bendelathouwer/Advanced-PCB/av en presentatie/Job1-13.jpg

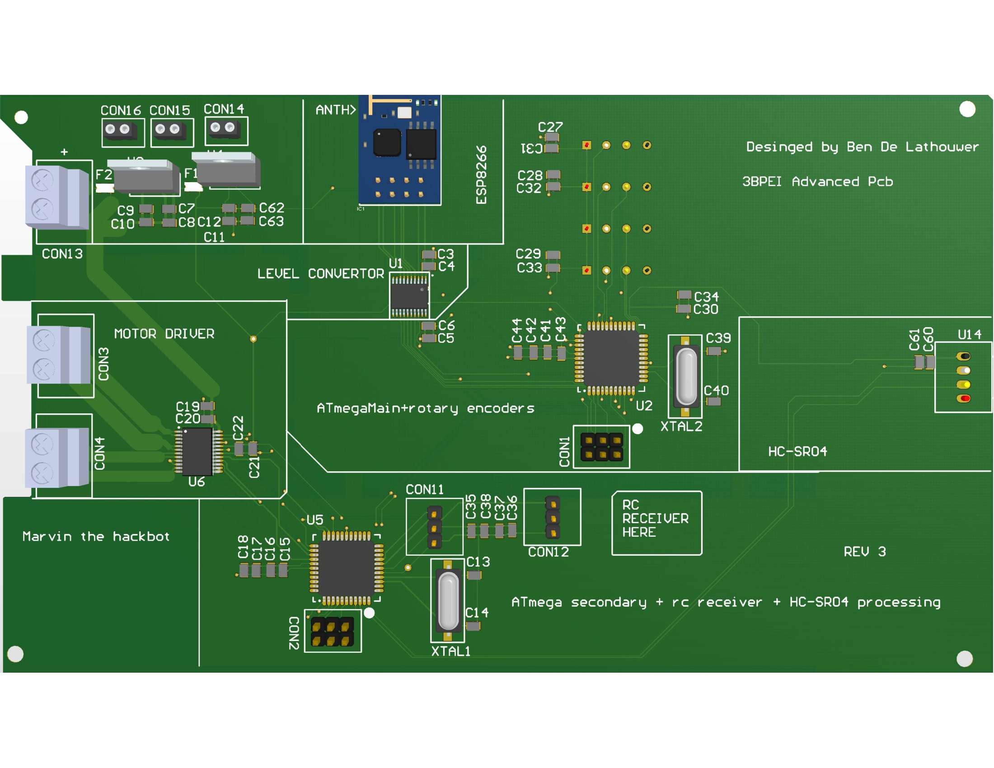
av en presentatie/Job1-13.jpg
