bendelathouwer/Advanced-PCB/av en presentatie/soort encoder.PNG

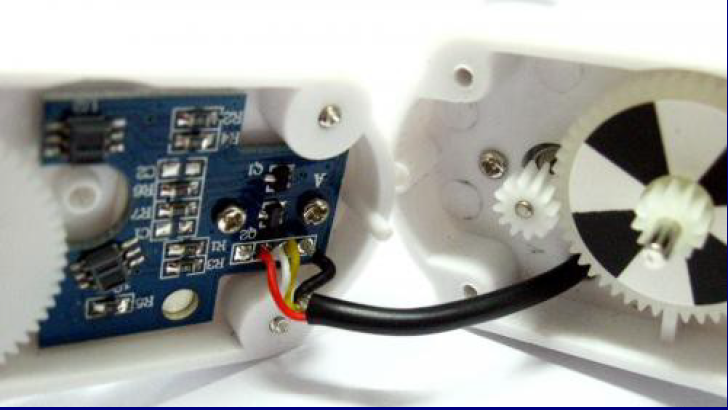
av en presentatie/soort encoder.PNG
