bendelathouwer/Advanced-PCB/Poster_BDL.pptx

- Marvin, the Paranoid Android

- Docent: J. Van Bauwel
- Vak: Project 2
- Student: Ben De Lathouwer
- Academiejaar: 2015-2016

- Doel

- Een rijdende RC robot die stopt als hij een obstakel te dicht naderT.

- componenten

- ATmega162 controller
- ultrasoon sensor
- motordriver
- Robot chassis met 4 Wielen (met elk een electro motor+ encoder)
- ESP8266p

Marvin

De programmeeromgeving

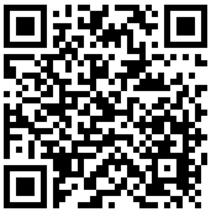
[picture p3: figure]

Onderkant Prototype van de print

- Patrick Pelgrims
- E-mail: Patrick.pelgrims@thomasmore.be
- Thomas More | Campus De Nayer
- Jan Pieter De Nayerlaan 5
- 2860 St.-Katelijne-Waver
- Tel: +32 (0)15 316944 | Fax: +32 (0)15 317453

Gebruikte onderdelen

## Slide 2

- Patrick Pelgrims
- E-mail: Patrick.pelgrims@thomasmore.be
- Thomas More | Campus De Nayer
- Jan Pieter De Nayerlaan 5
- 2860 St.-Katelijne-Waver
- Tel: +32 (0)15 316944 | Fax: +32 (0)15 317453

- Docent:Patric Pelgrims
- Jurre De Weerd
- Vak: Advanced Pcb
- Student: Ben De Lathouwer
- Academiejaar: 2016-2017

- Marvin, The Paranoid Android

- PCB verbeteringen

Layers

3D-render

- Meer interesse?

- Indien deze poster uw interesse geprikkeld heEft, kan u altijd mijn werk terugvinden op github:
- https://github.com/bendelathouwer/Psoc_robot
- voor vragen kan u me contacteren op: bendelathouwer@gmail.com

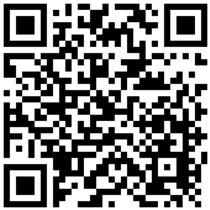
[picture p4: figure]
