bendelathouwer/Advanced-PCB/bestellijst farnell.docx

http://be.farnell.com/bourns/nsmf020-2/multifuse-smd-0-2a/dp/1206716

http://be.farnell.com/avx/08051a120jat2a/cap-mlcc-c0g-np0-12pf-100v-0805/dp/1740650

http://be.farnell.com/atmel/atmega162-16au/mcu-8bit-atmega-16mhz-tqfp-44/dp/9171150

http://be.farnell.com/littelfuse/0440002-wr/fuse-smd-2a-1206-fast-acting/dp/1835291
