bendelathouwer/Advanced-PCB/av en presentatie/Advanced pcb labo NL.pptx

## Advanced pcb labo

Henry the Hackbot
door Ben De Lathouwer

Henry the Hackbot

## Agenda

- Inleiding
- Doel van dit project
- Electronische schema’s en vergelijking
- Overzicht verbeteringen V4
- Wat heb ik geleerd?
- Vragen en Antwoorden

## Inleiding

- Leren werken met SMD PCB:
  - Debuggen
  - Solderen ‘in het klein’
- Gebruik van Altium

## Doel van het project

- Verbetering van het vak: project 2
  - Van Marvin naar Henry
- Mecatronica onder de knie krijgen
- Henry:
  - Gaat botsingen vermijden

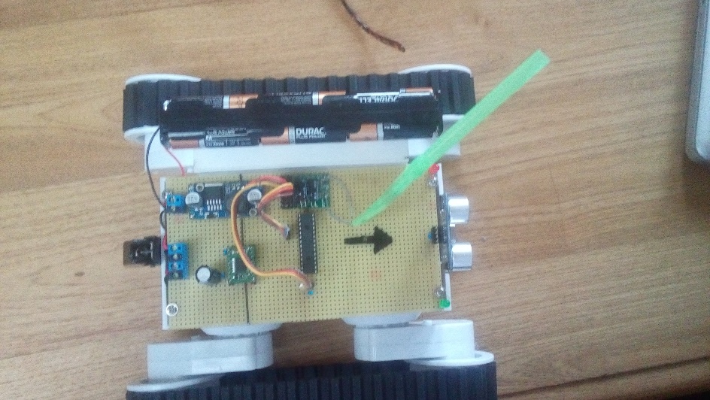
[picture p5: figure]

## Hoofd microcontroller

- Onderdelen:
  - Data genereren voor ESP8266
  - Level convertor sturen
  - Data van de secundaire controller ontvangen
  - Encoders uitlezen

## Hoofd microcontroller V2

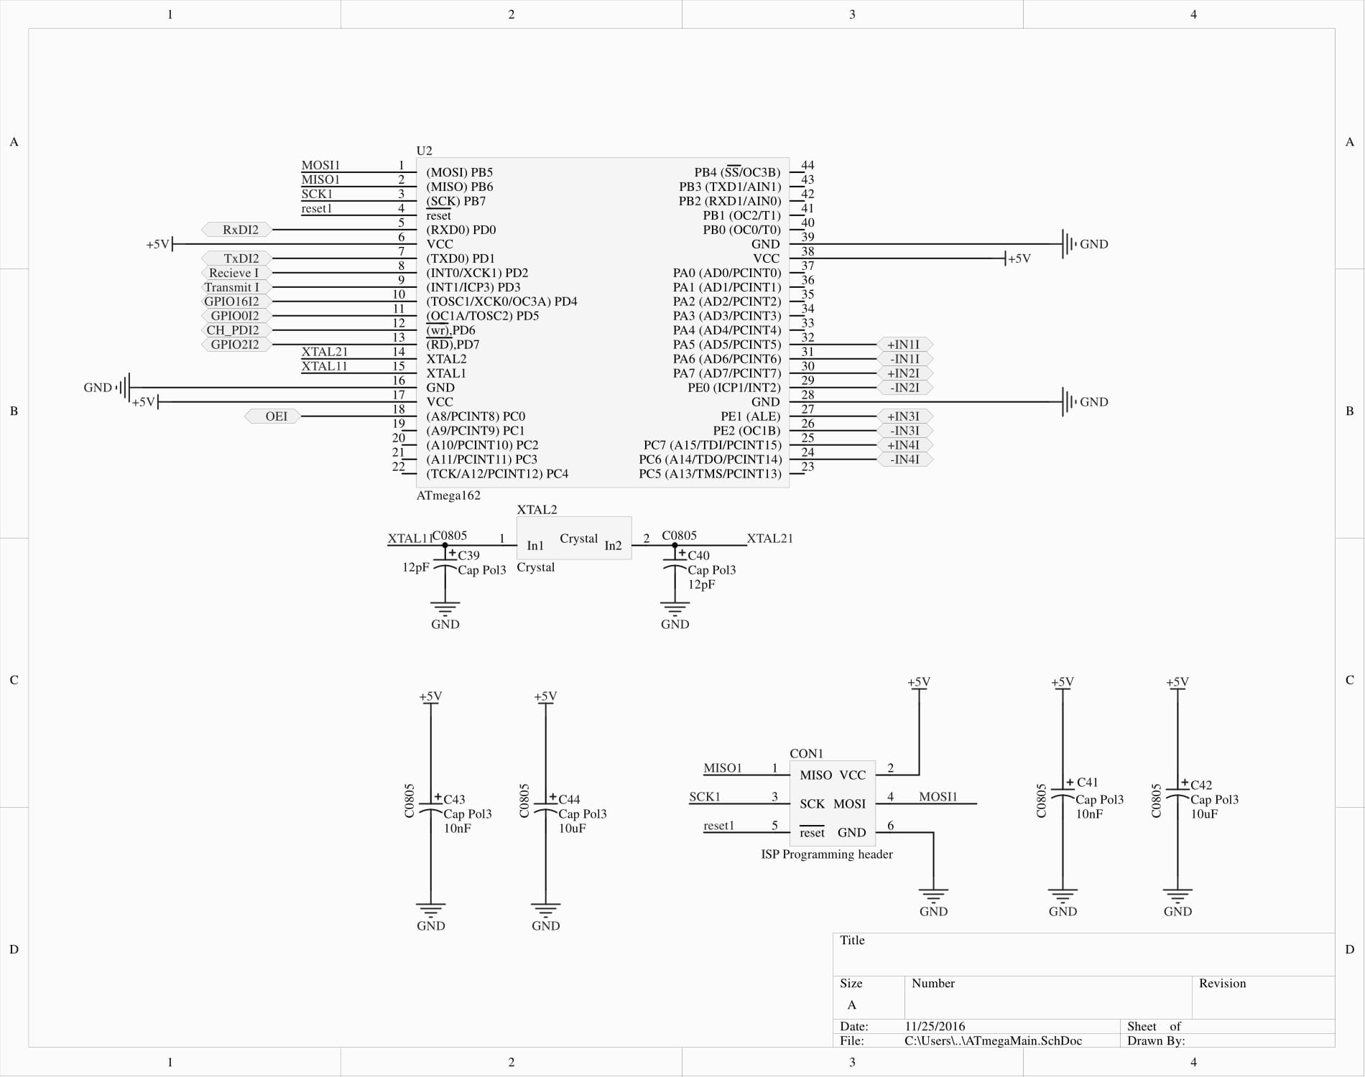
[picture p6: figure]

## Hoofd microcontroller V3

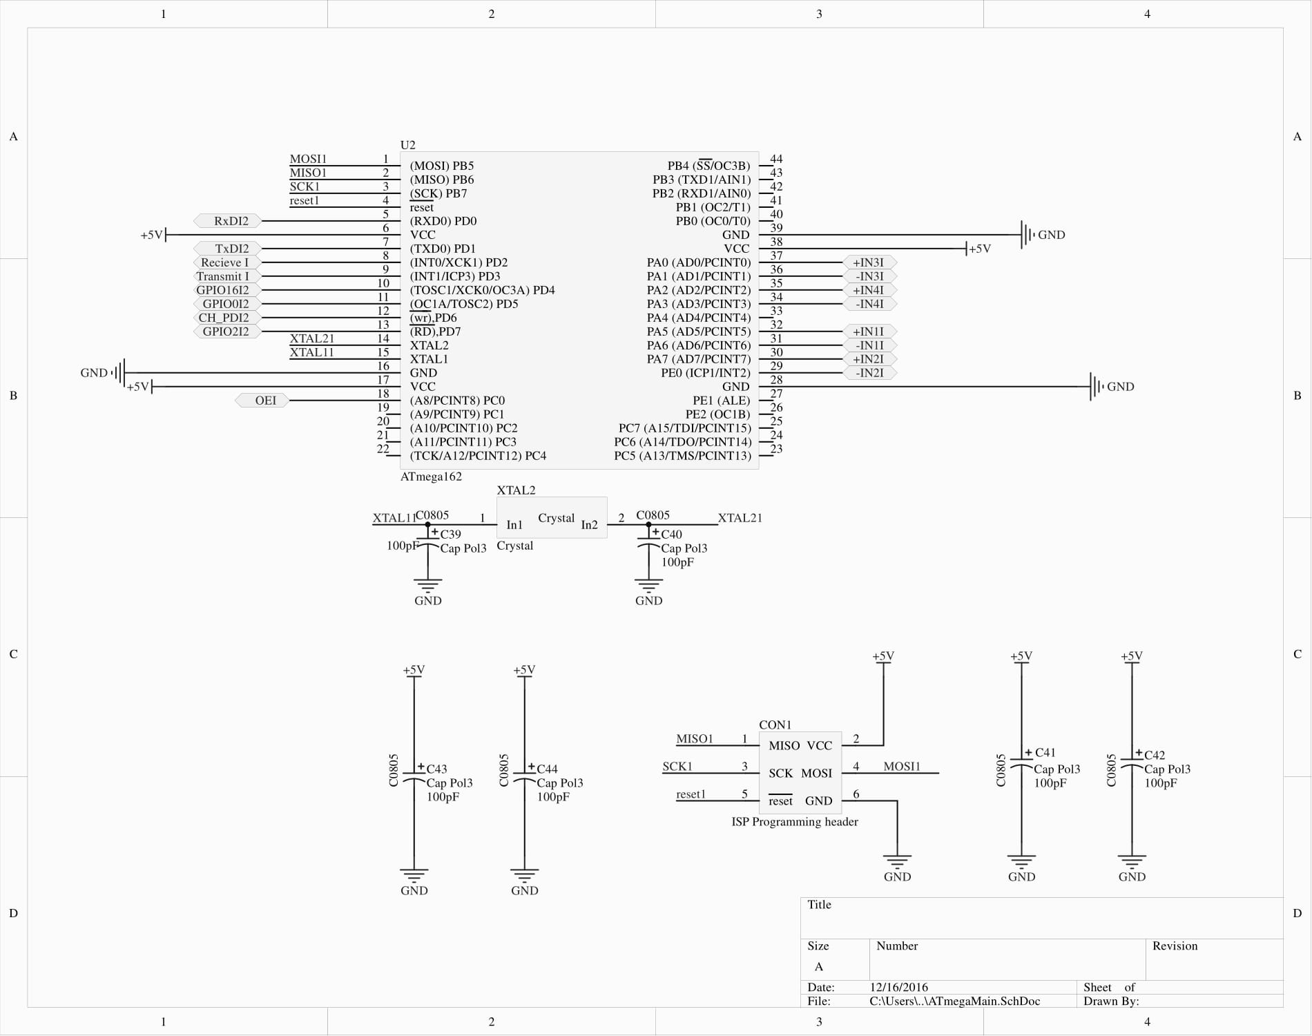
[picture p7: figure]

Alles naar interrupt pins

## Secundaire microcontroller

- Onderdelen:
  - PWM genereren voor de motordriver
  - De motordriver aansturen
  - Data zenden naar de hoofd controller
  - HC-SR04 aansturen en uitlezen

## Secundaire micro controller

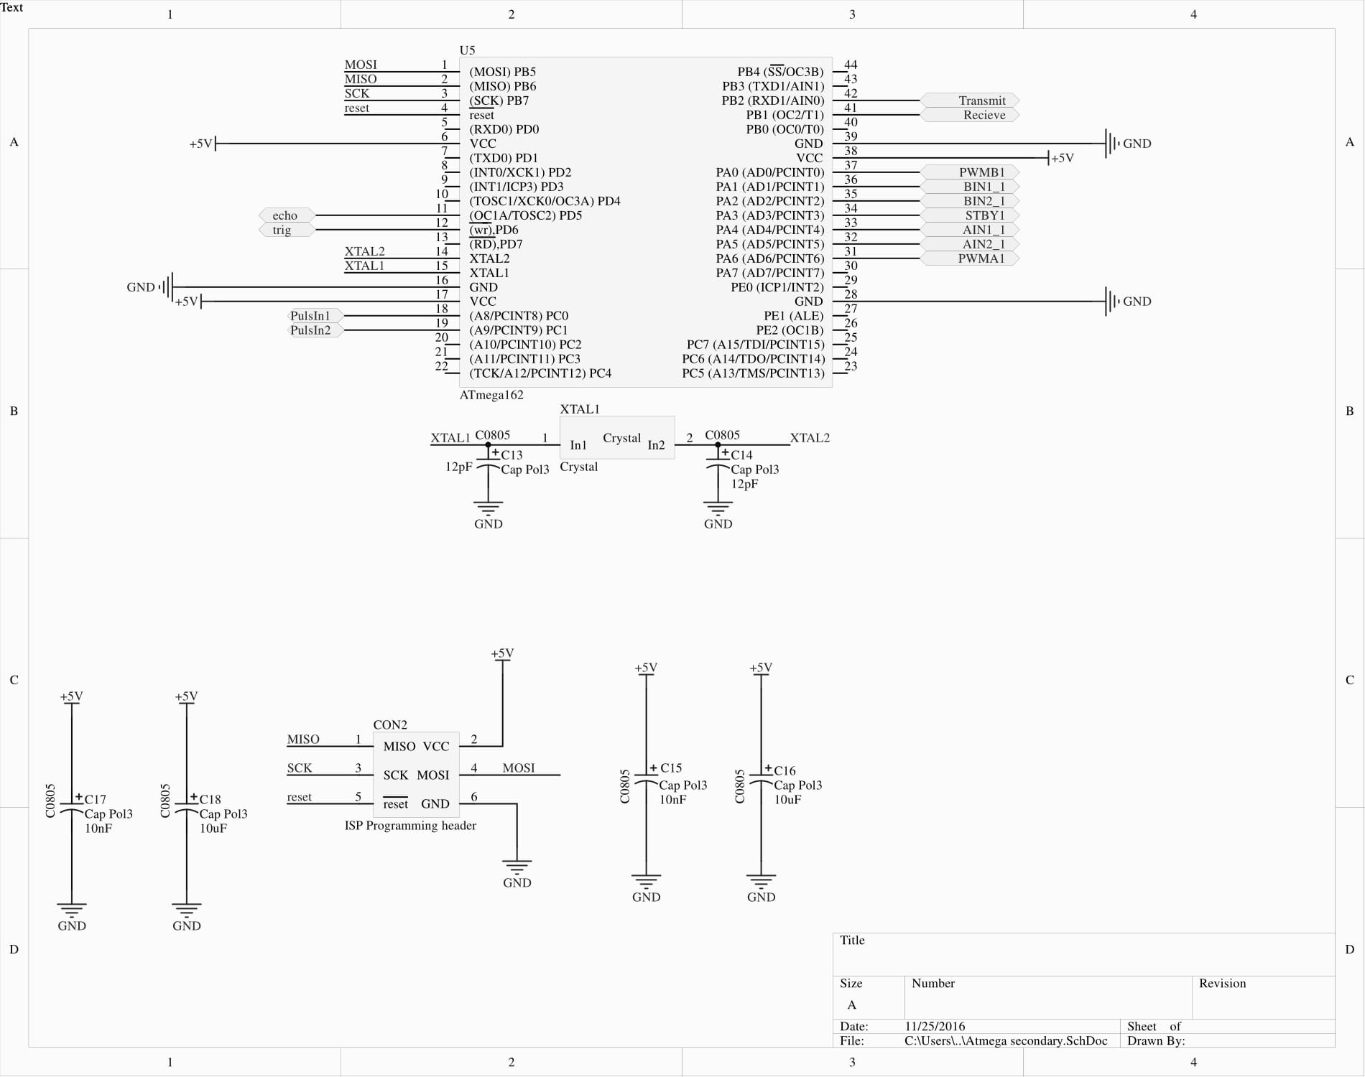
[picture p8: figure]

## Secundaire micro controller

Alles naar interrupt pins

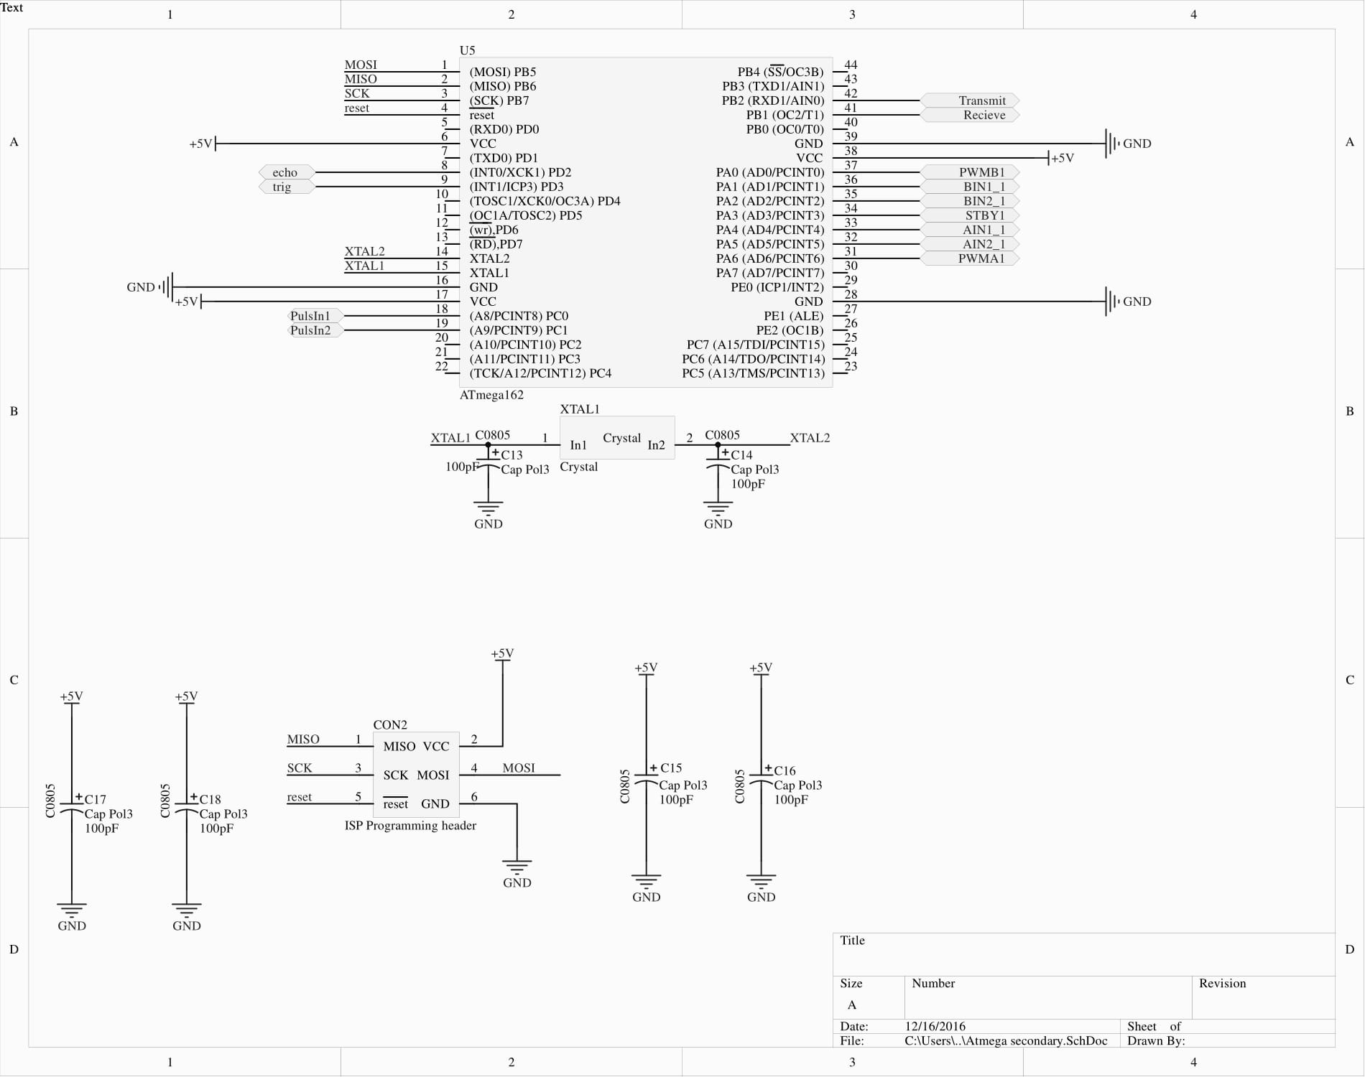
[picture p9: figure]

## Waarom 2 microcontrollers?

- De interrupt belasting verdelen tussen 2 microcontrollers
- Meer I/O’s beschikbaar

## Encoders

- Rover chassis => quadrature encoders
- Verschillende sensoren in encoders
  - Optisch(ir paar) => zwart wit oppervlak
  - Magnetisch(hal sensor ) => magneet op as
- Pulsen 90 graden uit fase=> richting bepaling

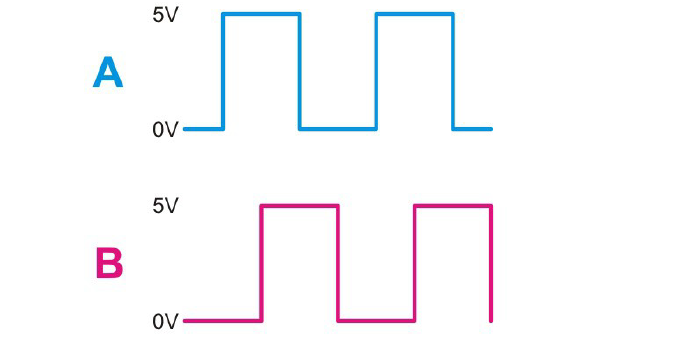
[picture p10: figure]
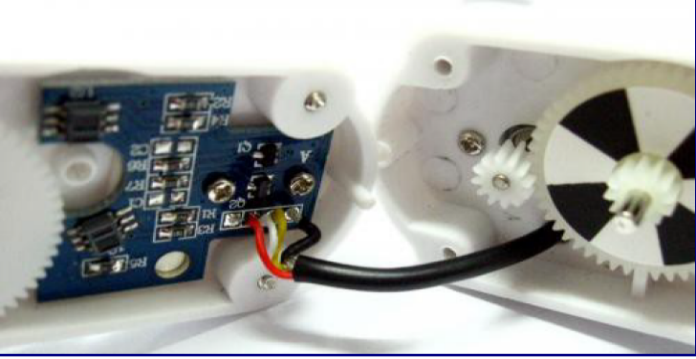
[picture p11: figure]

## Encoder verbetering

- Samenvoeging van 2 encoder outputs
  - Via XOR poort
- Voordelen
  - Minder I/O gebruikt
  - Minder interrupts gebruikt
- Nadelen
  - 1 component extra
  - Geen indicatie van richting

## Encoder verbetering

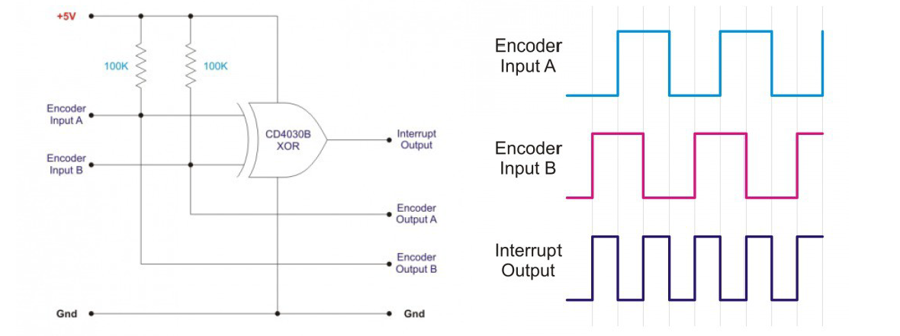
[picture p12: figure]

Bron: application note rover chasis

## Encoders

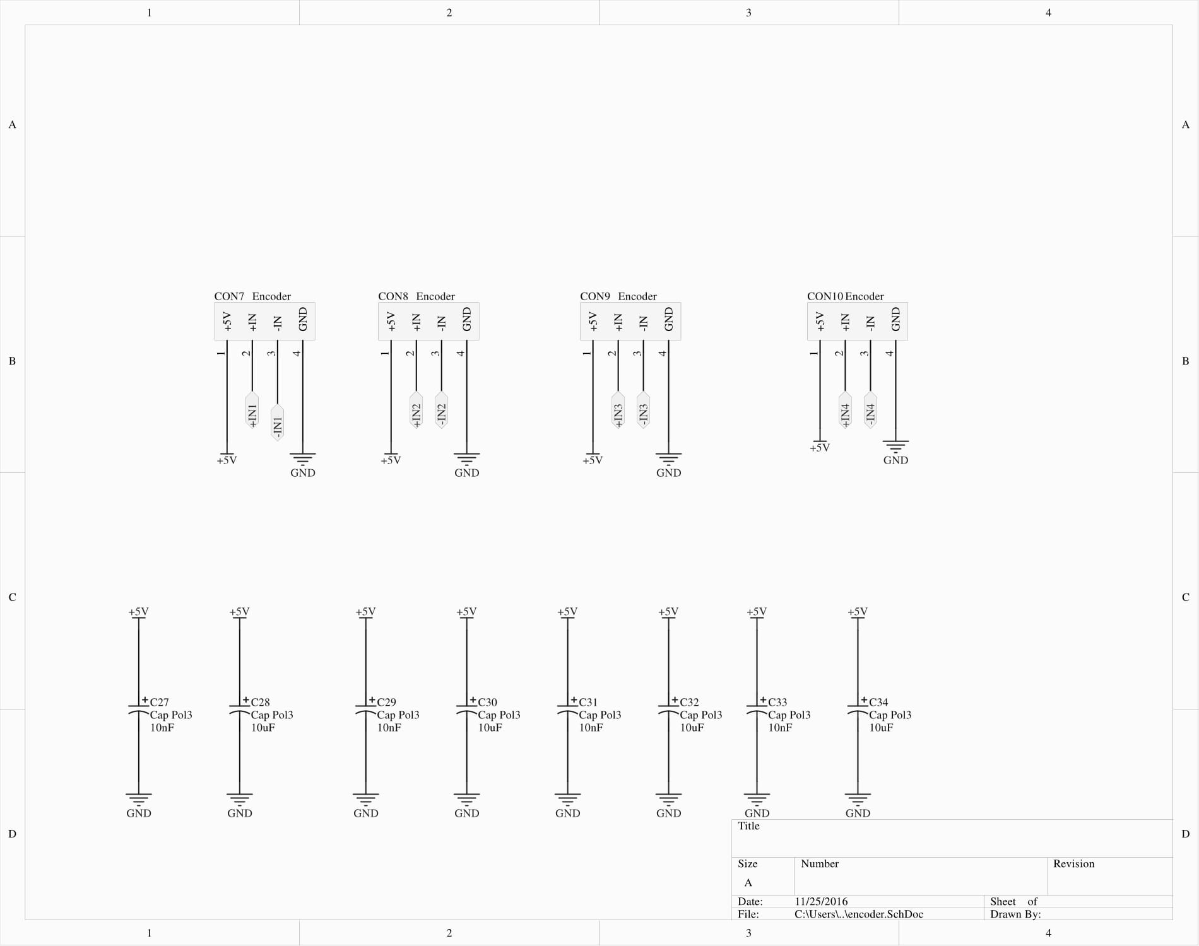
[picture p13: figure]

## ESP8266

- Goedkope wifi module (6 euro)
- Met System on chip aan boord
- Communicatie protocol => At commando’s via de seriële poort
- Geen componenten onder de antenne
- ALLEEN 3.3V!!
  - Geen 5V tolerante I/O

## ESP8266 V2 & V3

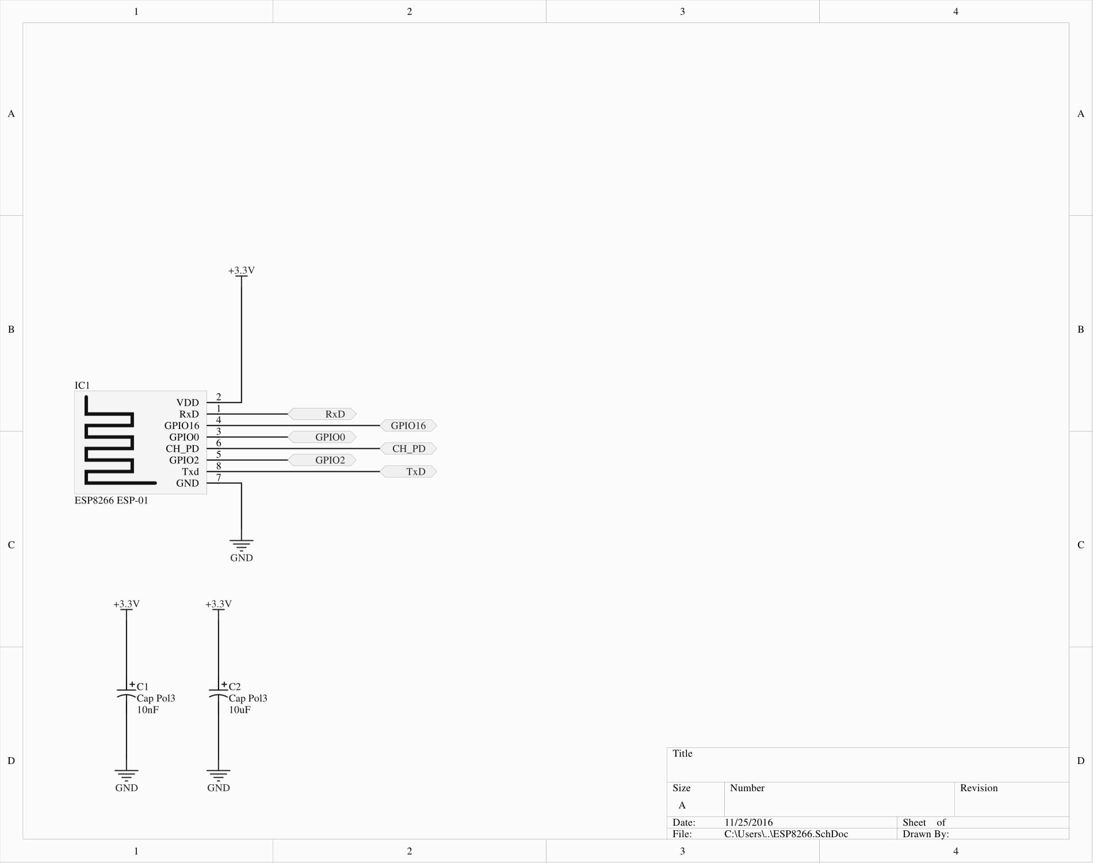
[picture p14: figure]

## Level shifter

- Converteert signalen naar een andere spanning
  - Bv 3.3V naar 5V en vice versa
- TXB0108 gebruikt 2 voedingen
  - Vcca => 1.2V tot 3.6V
  - Vccb => 1.6V tot 5.5V
- Moet gebruikt worden voor de esp8266
- Level shifter moet geactiveerd worden dmv OE pin

## Level shifter

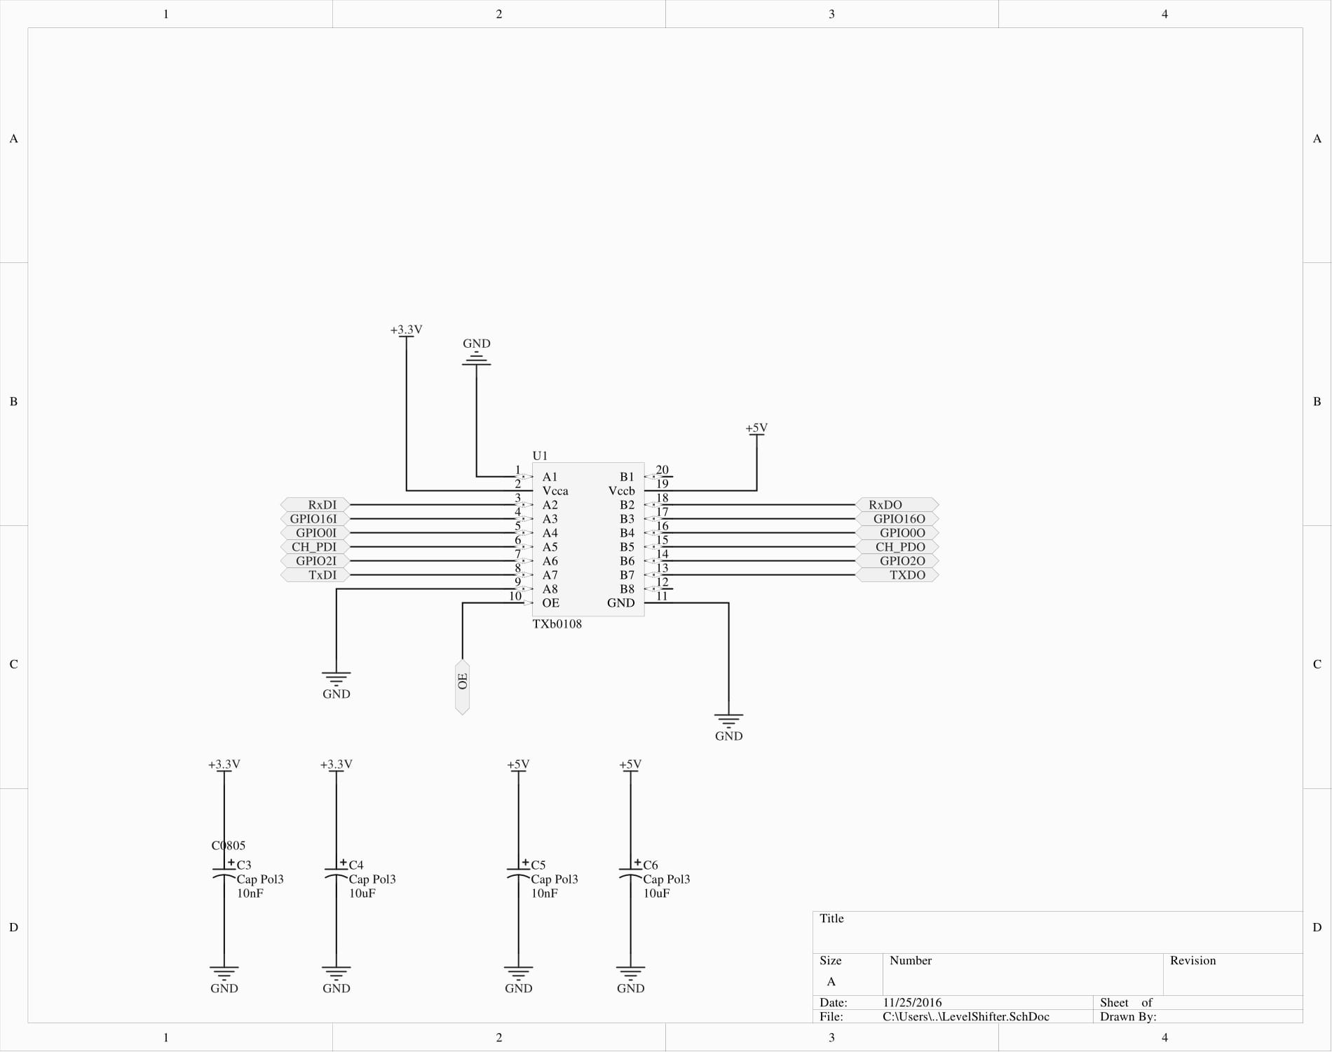
[picture p15: figure]

## Motor driver

- Gebruik H-brug
- TB6612FNG
  - H-brug met geïntegreerde controle elektronica en diodes
    - De ontwerper moet zich geen zorgen maken wat betreft de mosfets
  - Iout 1.2A max met piekstromen tot 3.2A

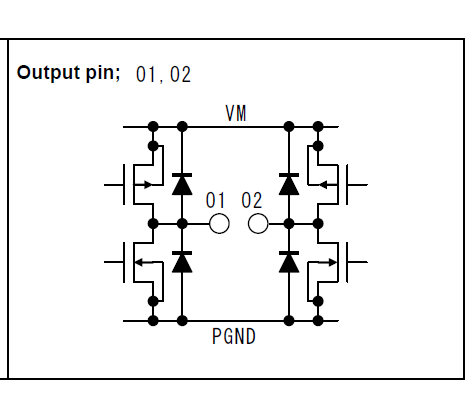
[picture p16: figure]

Bron: datasheet TB6612FNG

## Motor driver

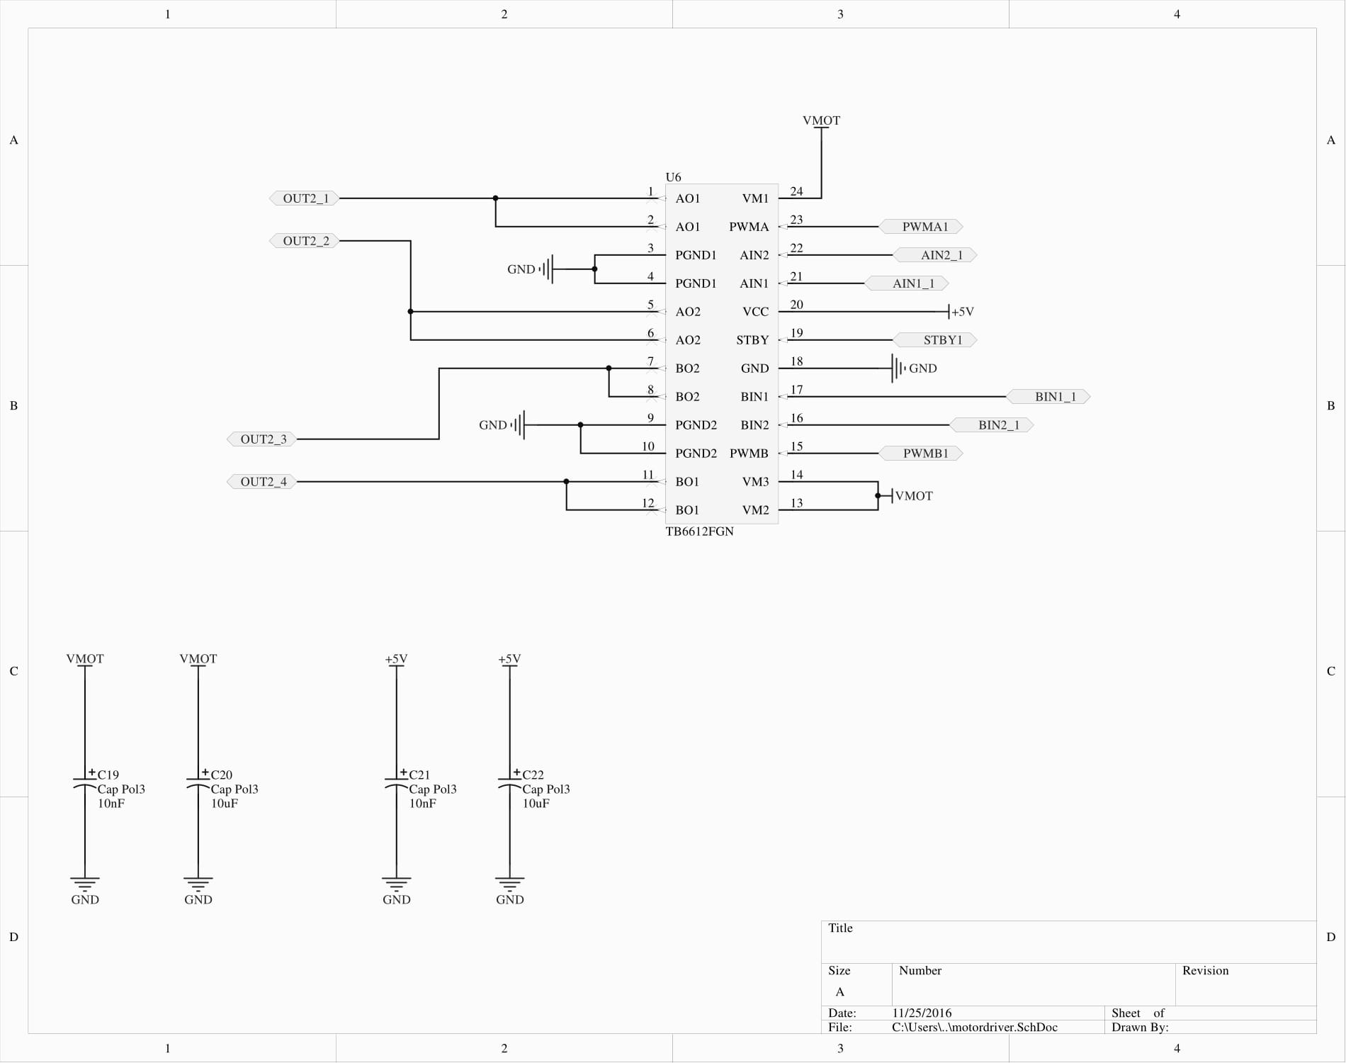
[picture p17: figure]

## Rc Receiver

- Standaard modelbouw rc ontvanger
- Servo output signaal
- Draadloze communicatie
- Wordt in de controller
omgezet naar PWM

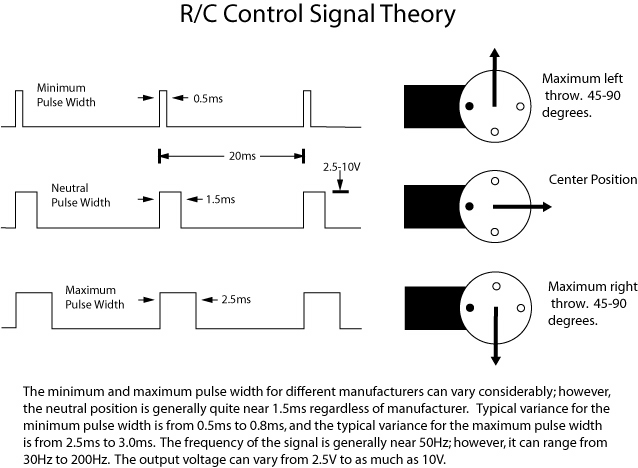
[picture p18: figure]

Bron: http://www.mitchr.me/SS/batteriesRequired/RCcontrolTheory/

## Rc receiver V2 & V3

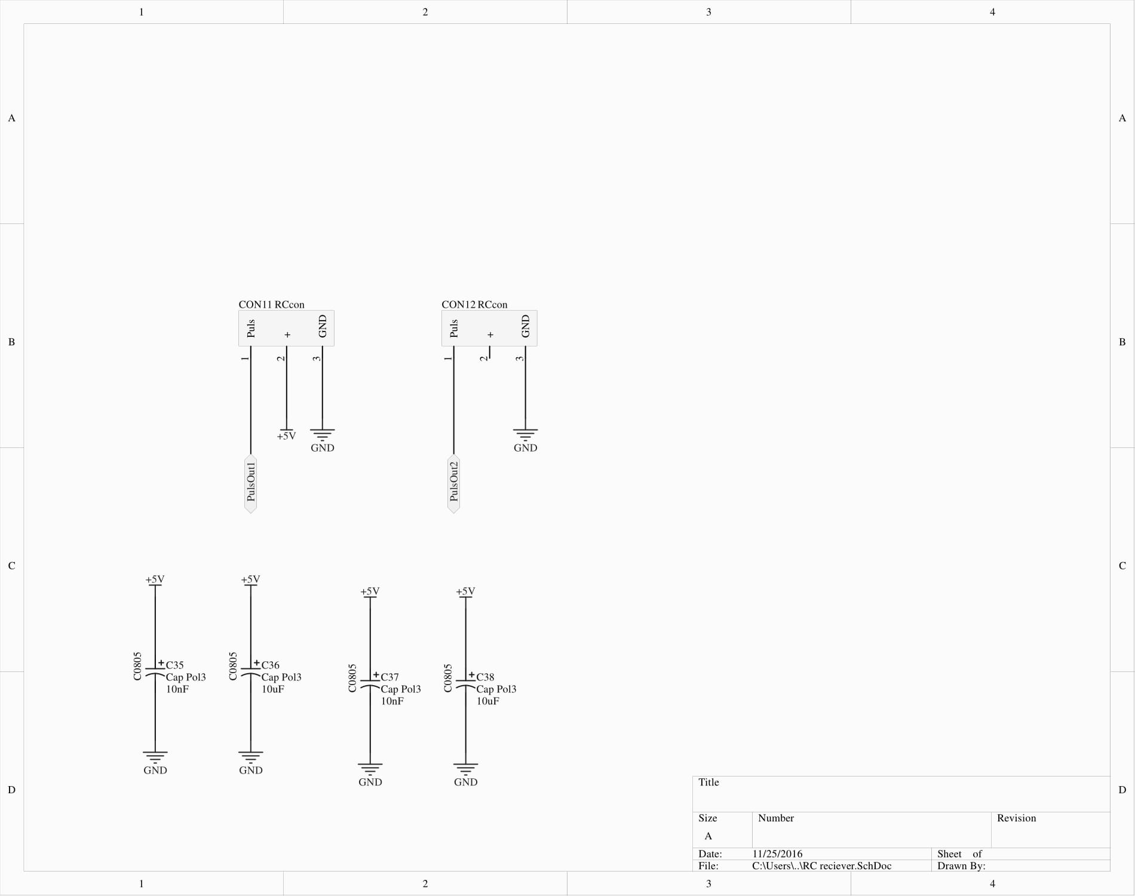
[picture p19: figure]

## Ultrasonic distance sensor

- Meetprincipe gebruikt geluid
- 4 pinnen
  - GND, VCC, trigger input en echo output
- Echo puls proportioneel tot de afstand
  - Afstand = High level time * snelheid/2
    - High level Time = duur van puls breedte (milli- of microseconde
    - Snelheid = 340m/s (luchtsnelheid)

## Ultrasonic distance sensor

- Meetafstand = 4 cm tot 4 meter
- Meethoek = 15 graden

## Theoretische signalen

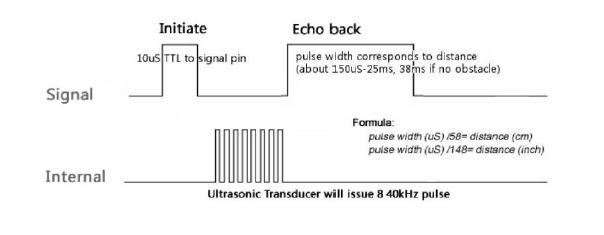
[picture p20: figure]

Bron: Datasheet HC-SR04

## Trigger puls

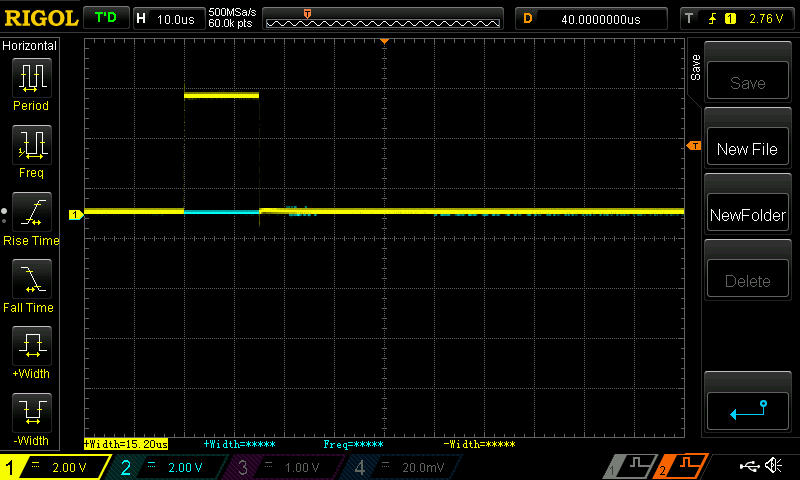
[picture p21: figure]

## Echo puls minimum afstand

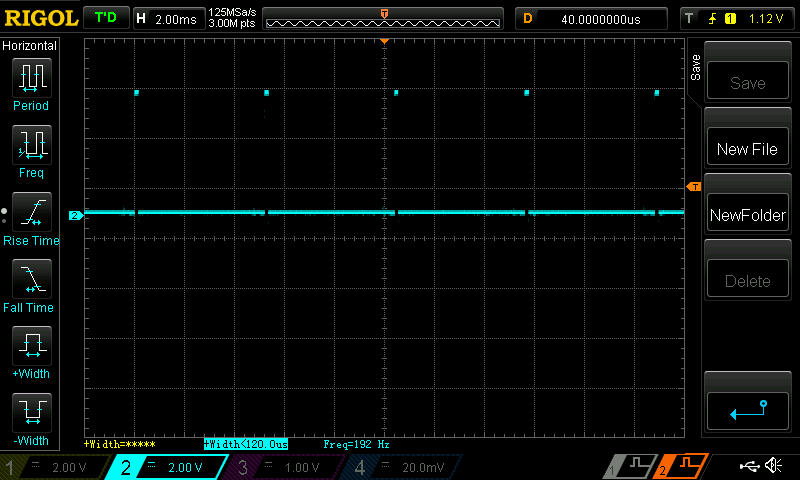
[picture p22: figure]

## Echo puls max afstand

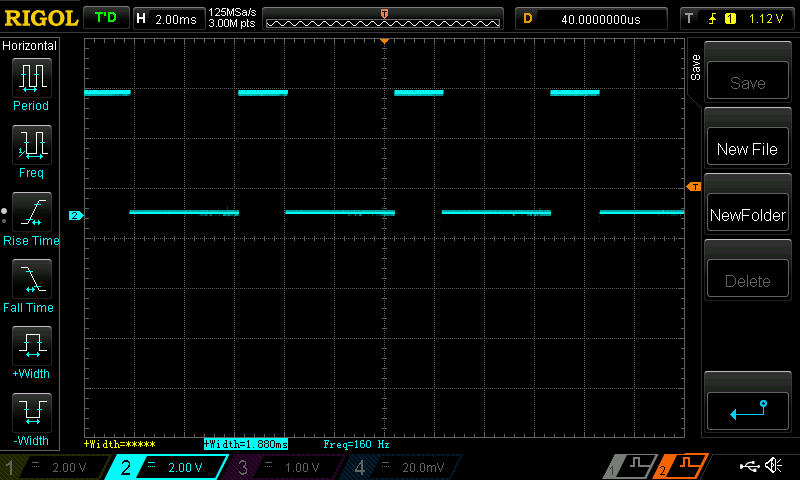
[picture p23: figure]

## Ultrasonic distance sensor V2 & V3

Geen verschil tussen V2 & V3

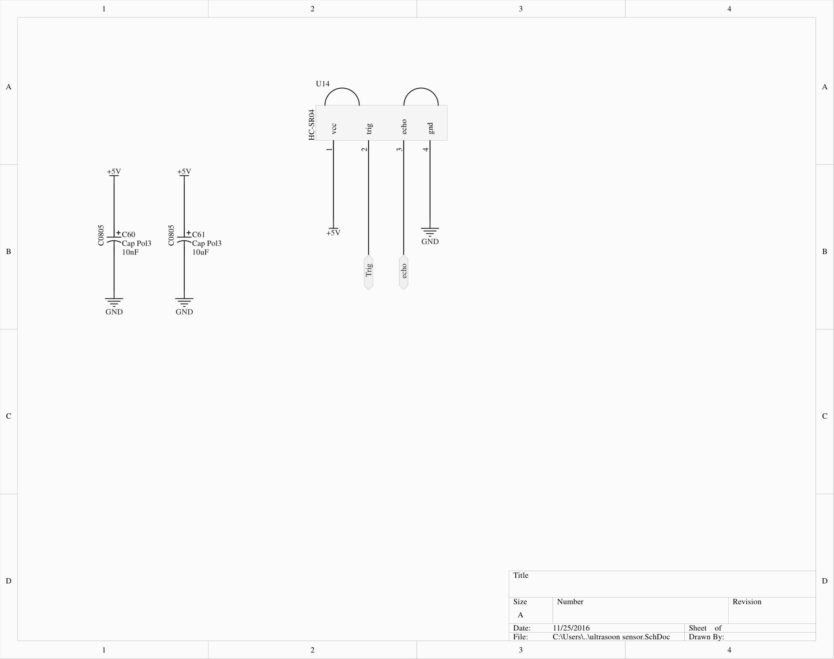
[picture p24: figure]

## Voeding

- Gebruikt LDO’s
  - Lagere dropout spanning
- Genereerd 5V en 3.3V voor de controle elektronica en ESP8266

## Voeding V2

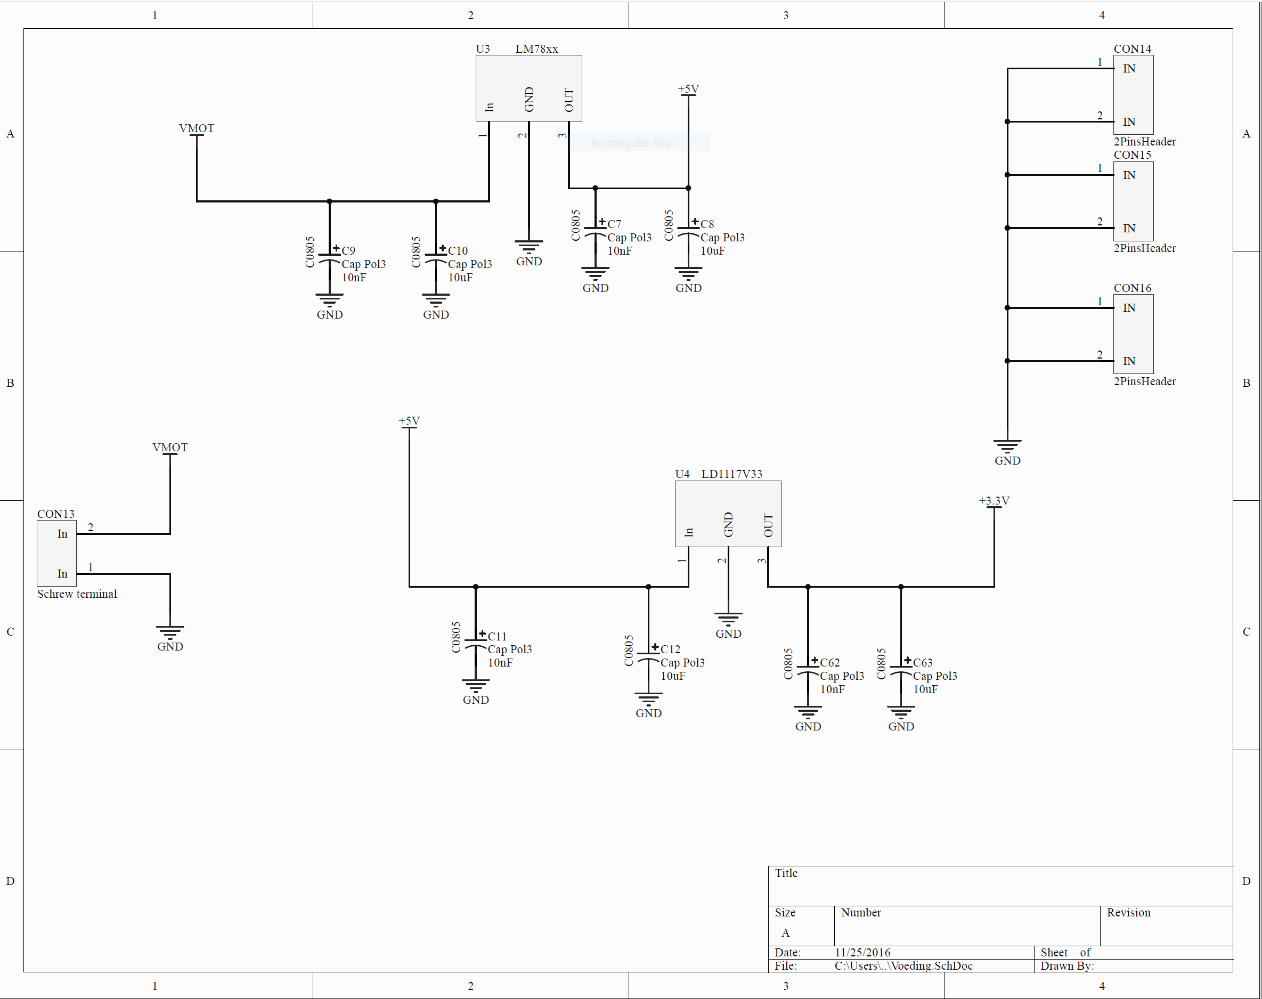
[picture p25: figure]

## Voeding V3

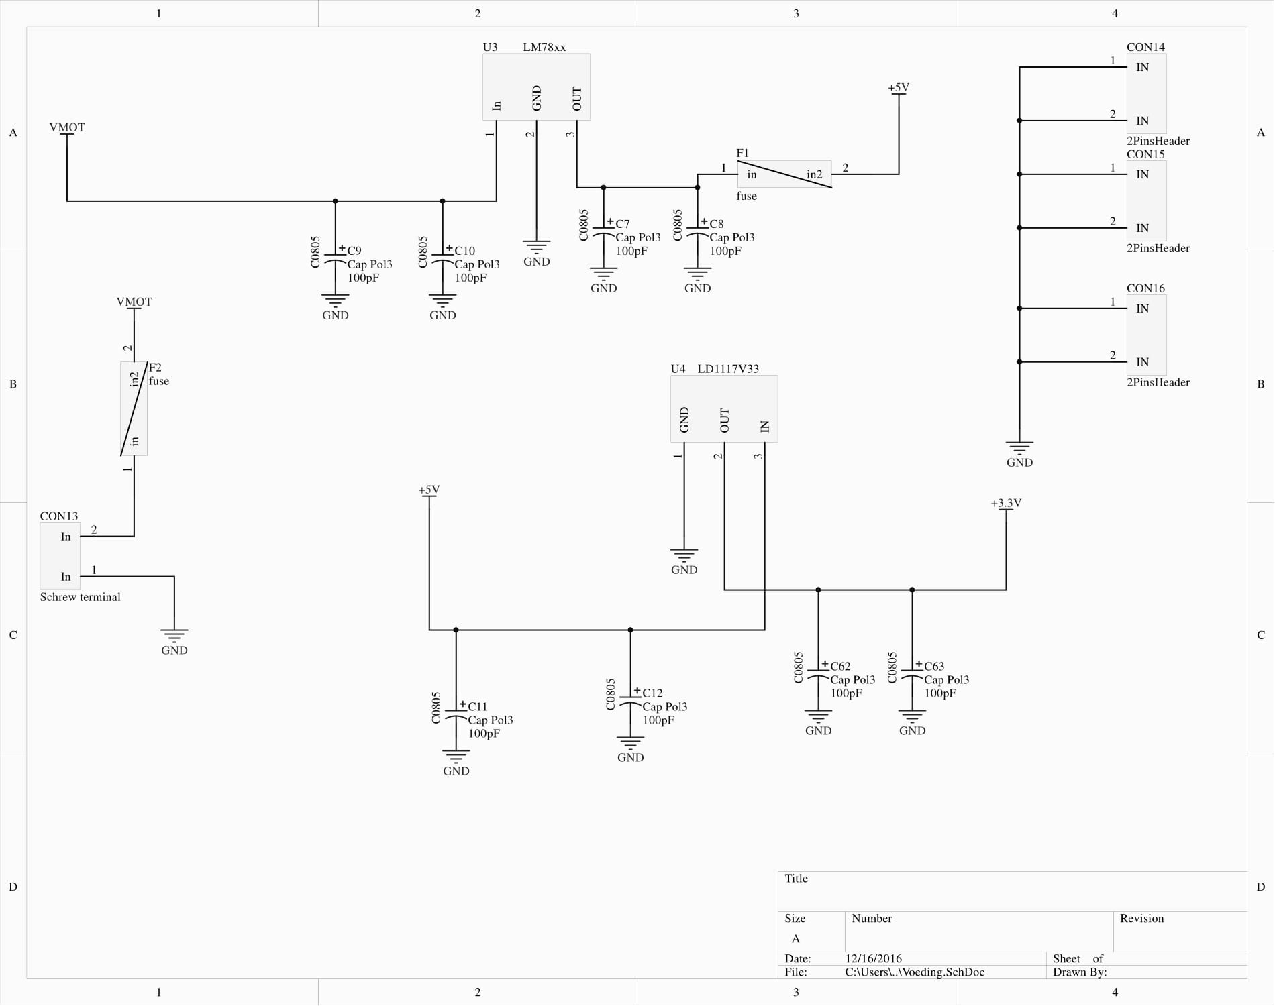
[picture p26: figure]

## Verbeteringen voor MK4 pcb

- Gebruiken van stroomsensors
- Betere microcontroller gebruiken
  - meer periferie
- PCB resizing

## Wat heb ik geleerd

- Circuit design
- Denken dan ontwerpen
  - Eerst data sheet lezen
  - Dan footprint tekenen ,..
- ‘High current’ ontwerp
- ‘Design flow’ van Altium

## Vragen en antwoorden

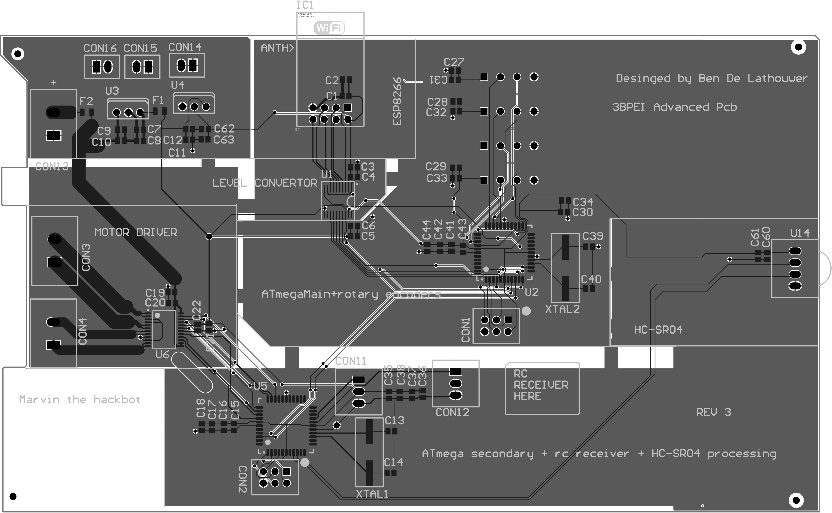
[picture p27: figure]
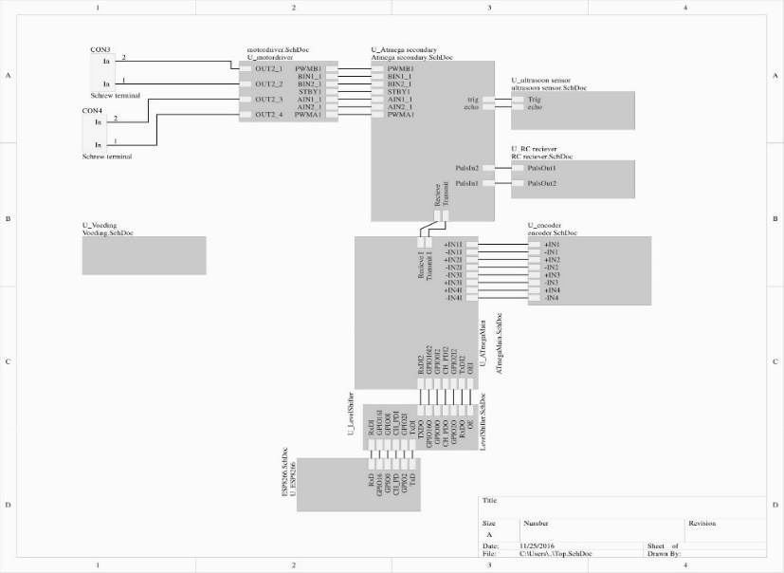
[picture p28: figure]
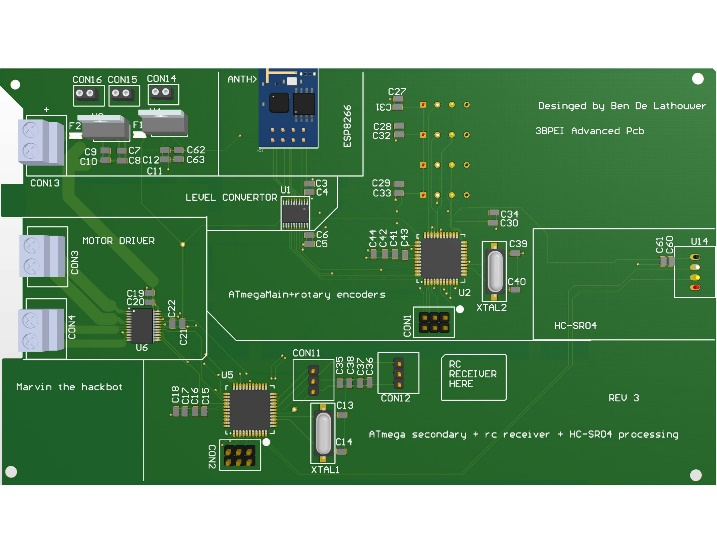
[picture p29: figure]
