bendelathouwer/Advanced-PCB/av en presentatie/fuses.PNG

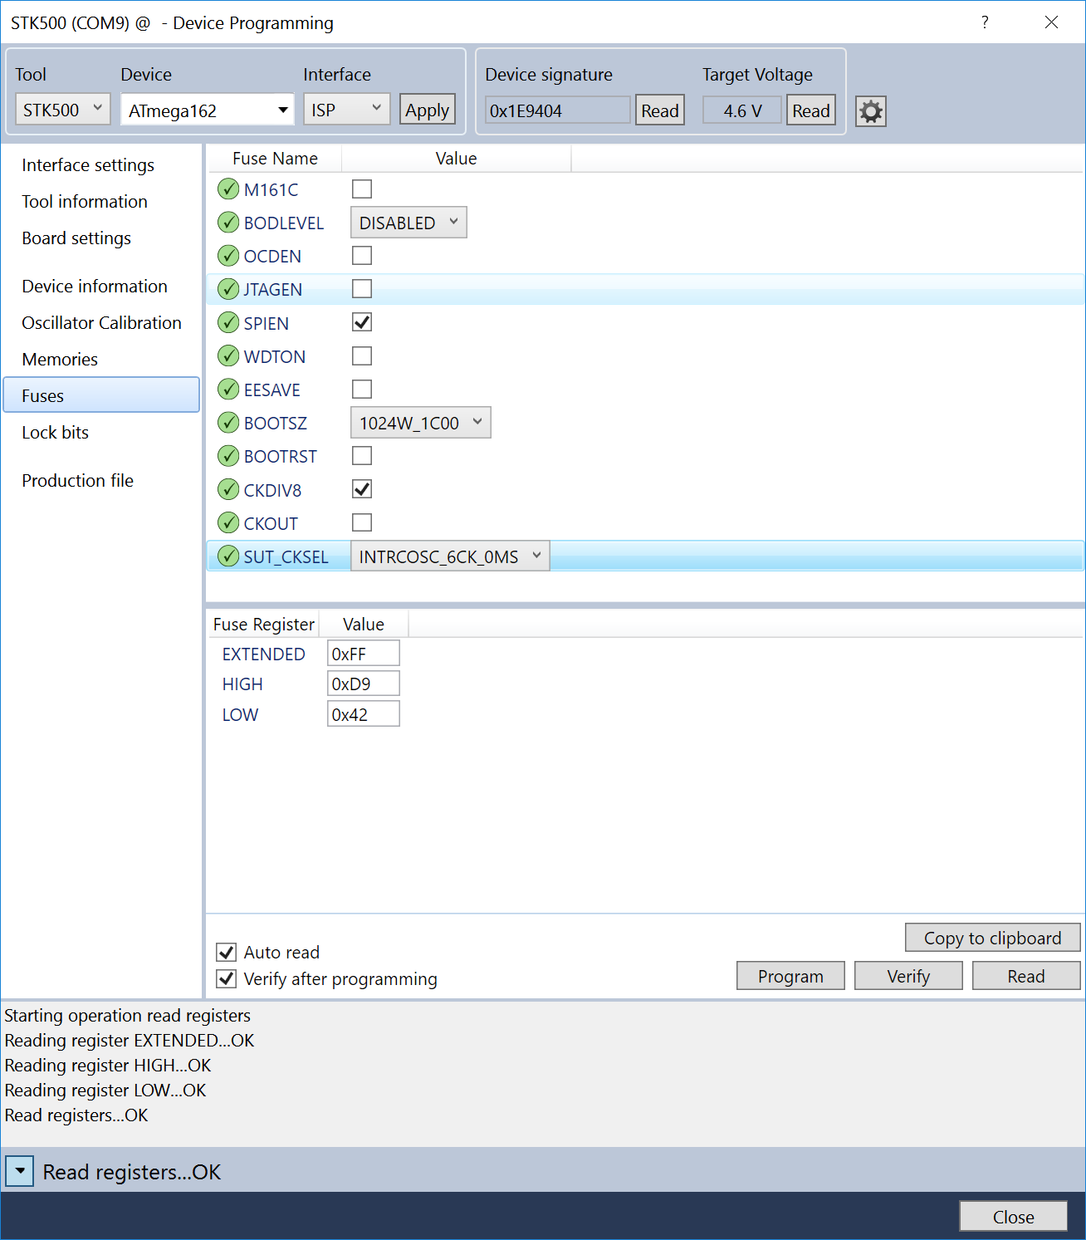
av en presentatie/fuses.PNG
