bendelathouwer/Advanced-PCB/av en presentatie/IMG_7310.JPG

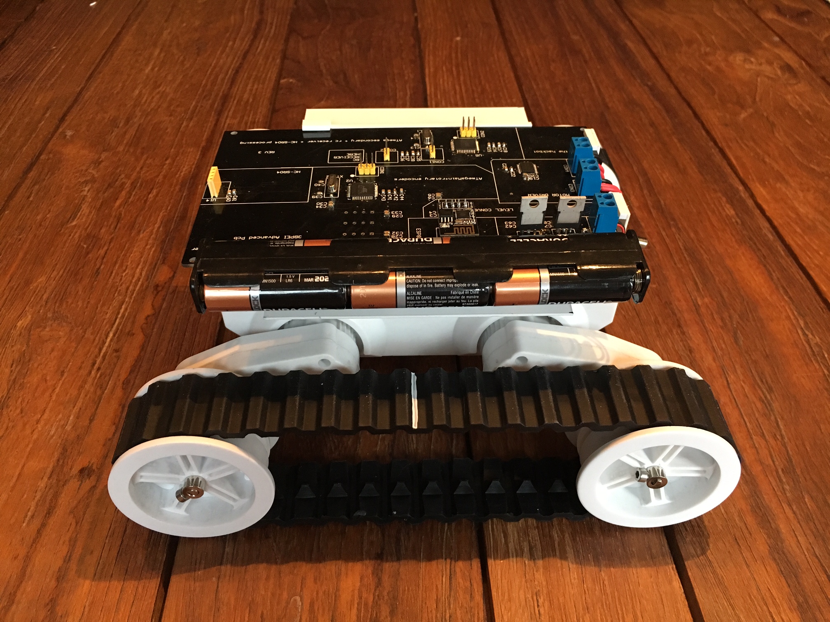
av en presentatie/IMG_7310.JPG
