bendelathouwer/Advanced-PCB/av en presentatie/IMG_7311.JPG

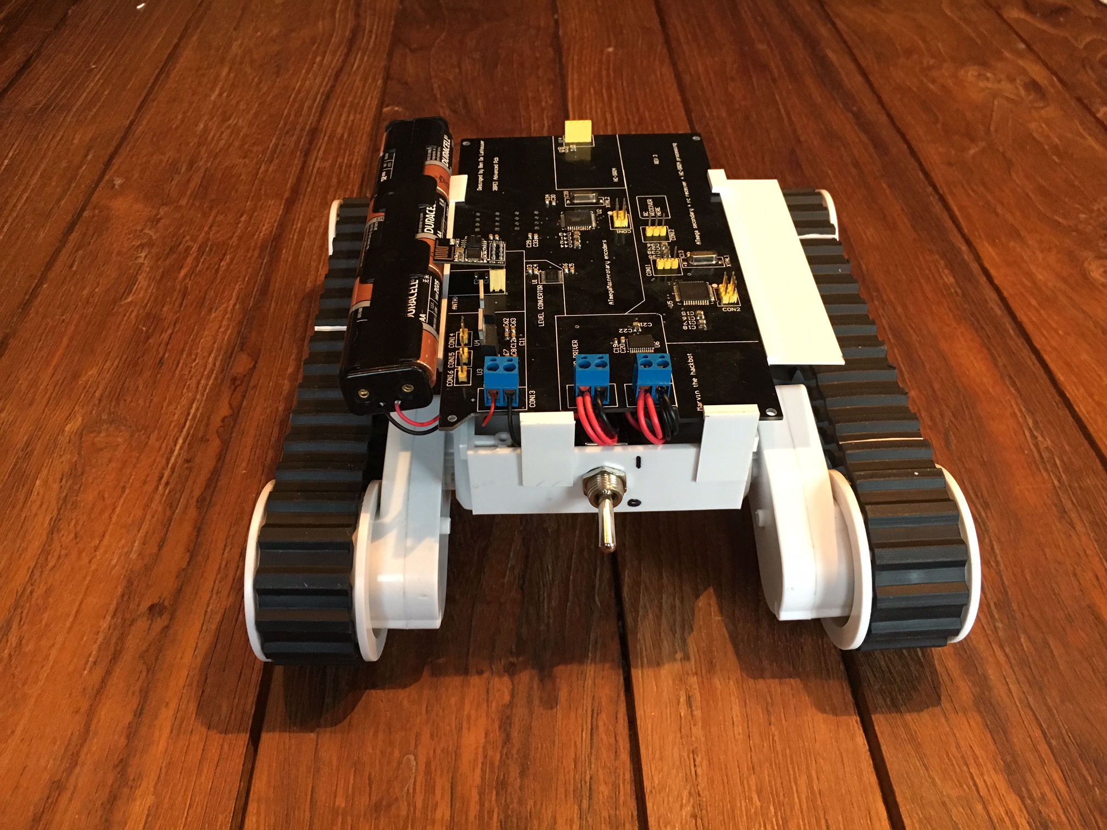
av en presentatie/IMG_7311.JPG
