bendelathouwer/Advanced-PCB/av en presentatie/IMG_7312.JPG

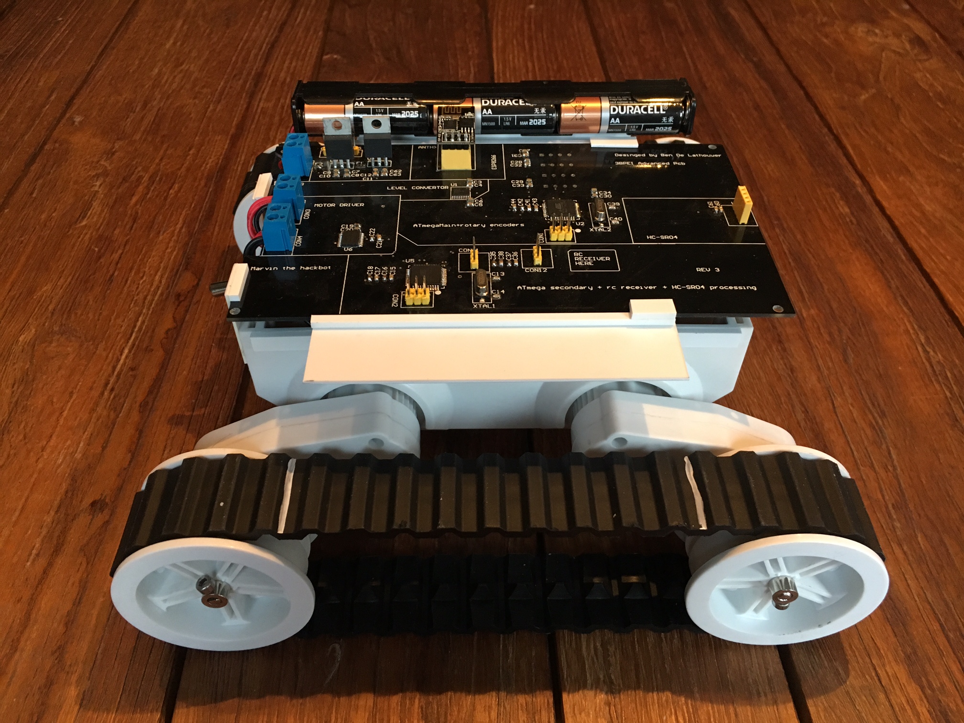
av en presentatie/IMG_7312.JPG
