bendelathouwer/Advanced-PCB/av en presentatie/IMG_7313.JPG

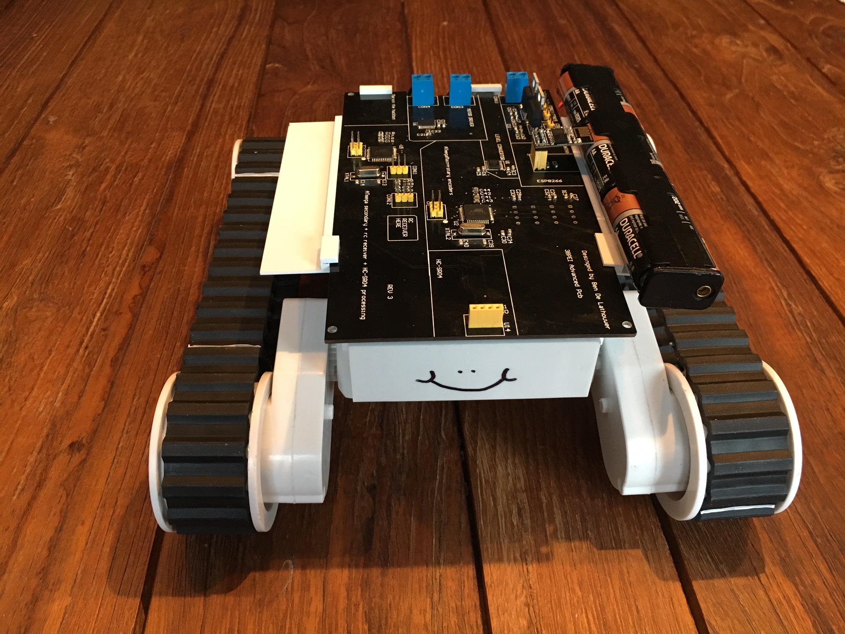
av en presentatie/IMG_7313.JPG
