bendelathouwer/Advanced-PCB/av en presentatie/IMG_7314.JPG

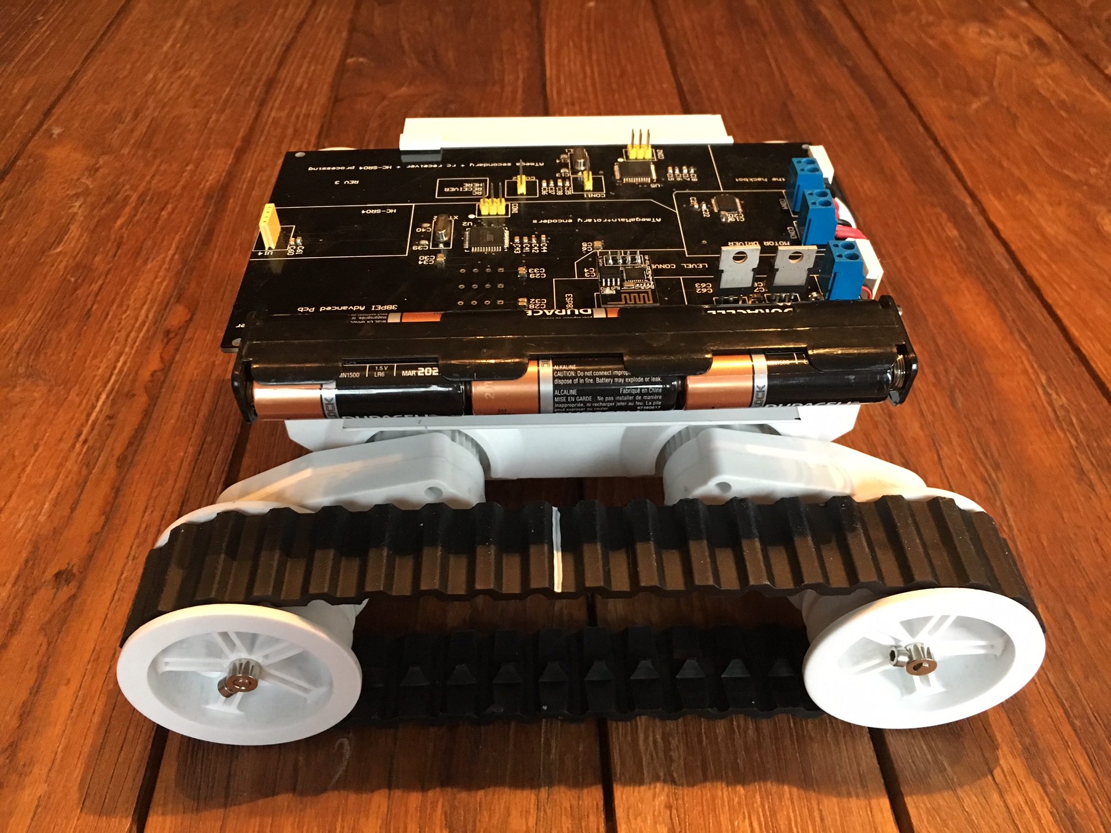
av en presentatie/IMG_7314.JPG
