bendelathouwer/Advanced-PCB/av en presentatie/IMG_7315.JPG

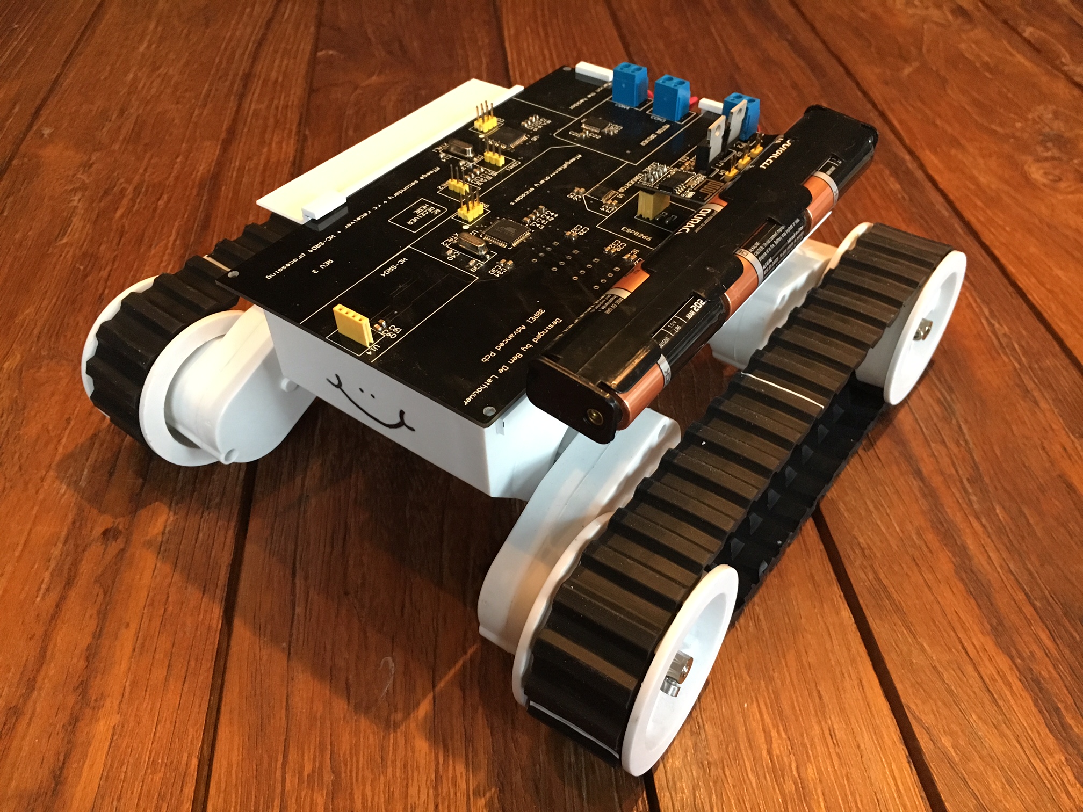
av en presentatie/IMG_7315.JPG
