bendelathouwer/Advanced-PCB/av en presentatie/IMG_7316.JPG

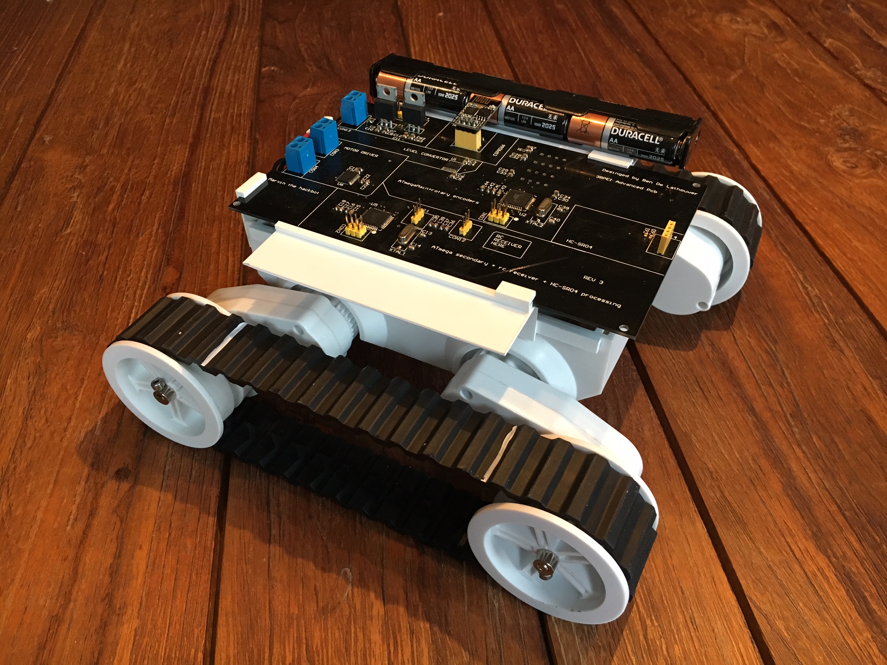
av en presentatie/IMG_7316.JPG
