bendelathouwer/Advanced-PCB/av en presentatie/IMG_7317.JPG

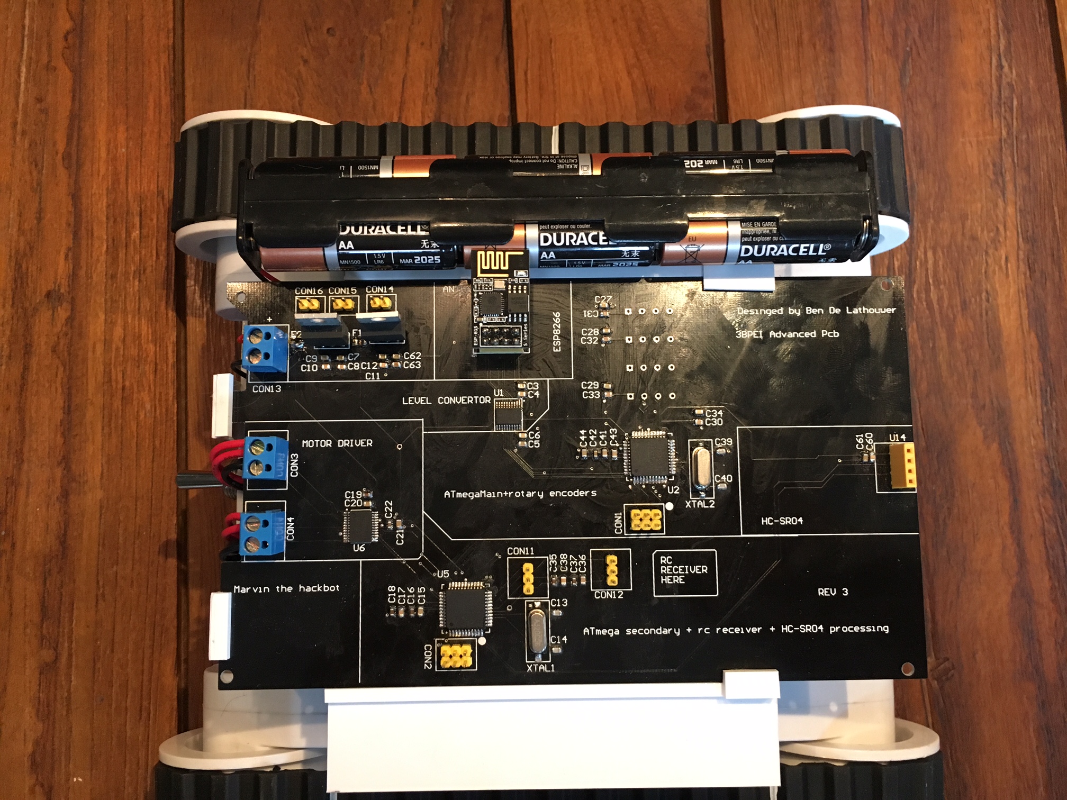
av en presentatie/IMG_7317.JPG
