bendelathouwer/Advanced-PCB/av en presentatie/IMG_7318.JPG

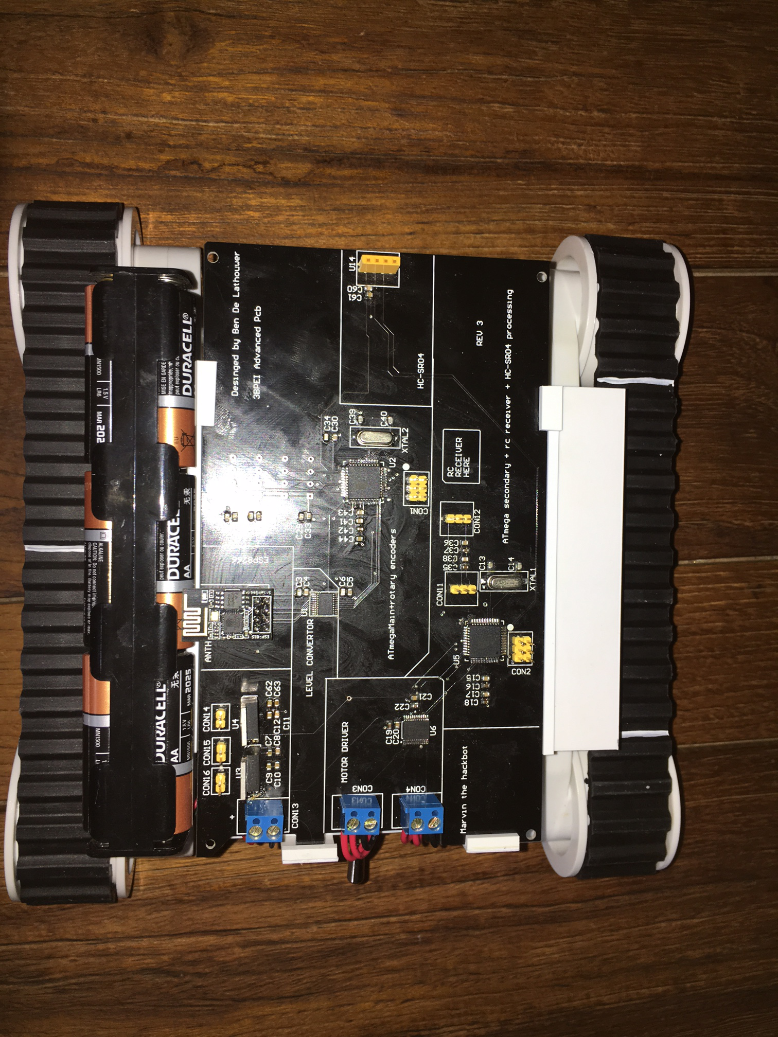
av en presentatie/IMG_7318.JPG
