bendelathouwer/Advanced-PCB/av en presentatie/IMG_7319.JPG

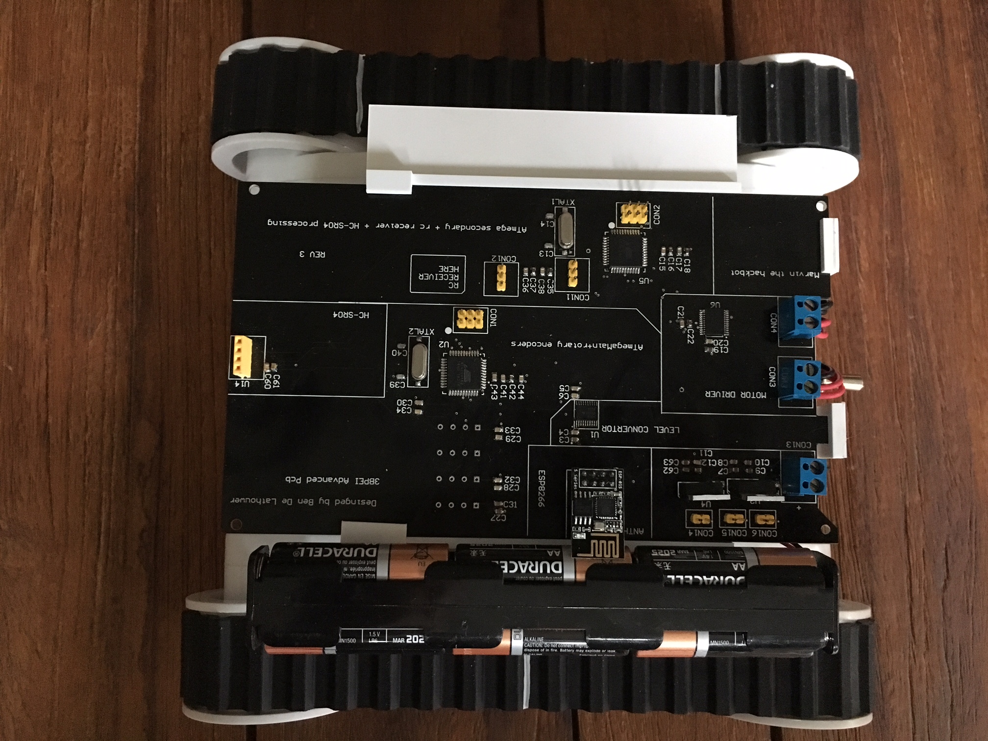
av en presentatie/IMG_7319.JPG
