bendelathouwer/Advanced-PCB/av en presentatie/IMG_7320.JPG

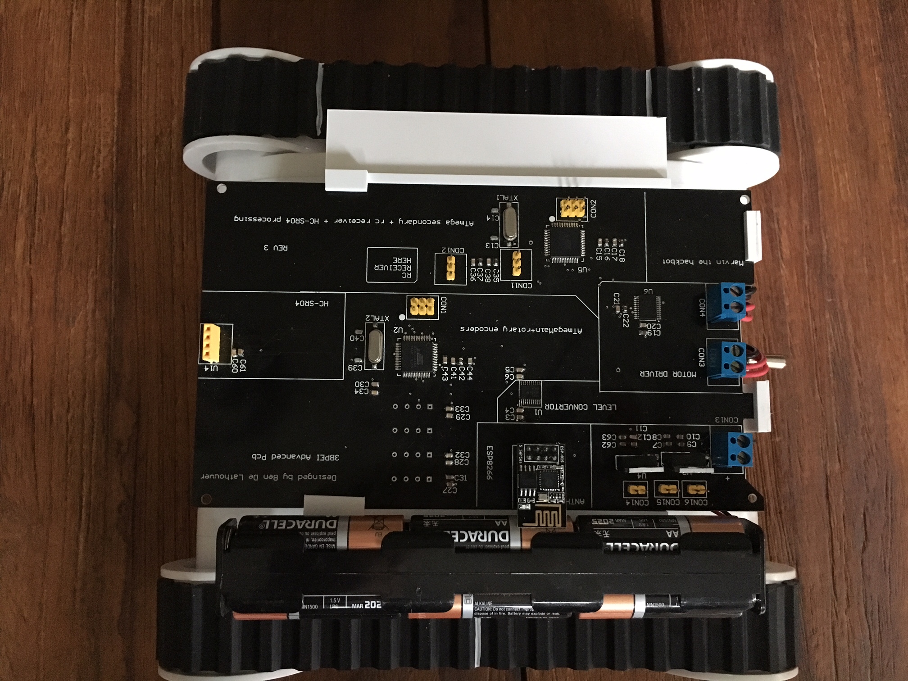
av en presentatie/IMG_7320.JPG
