bendelathouwer/Advanced-PCB/av en presentatie/IMG_7329.JPG

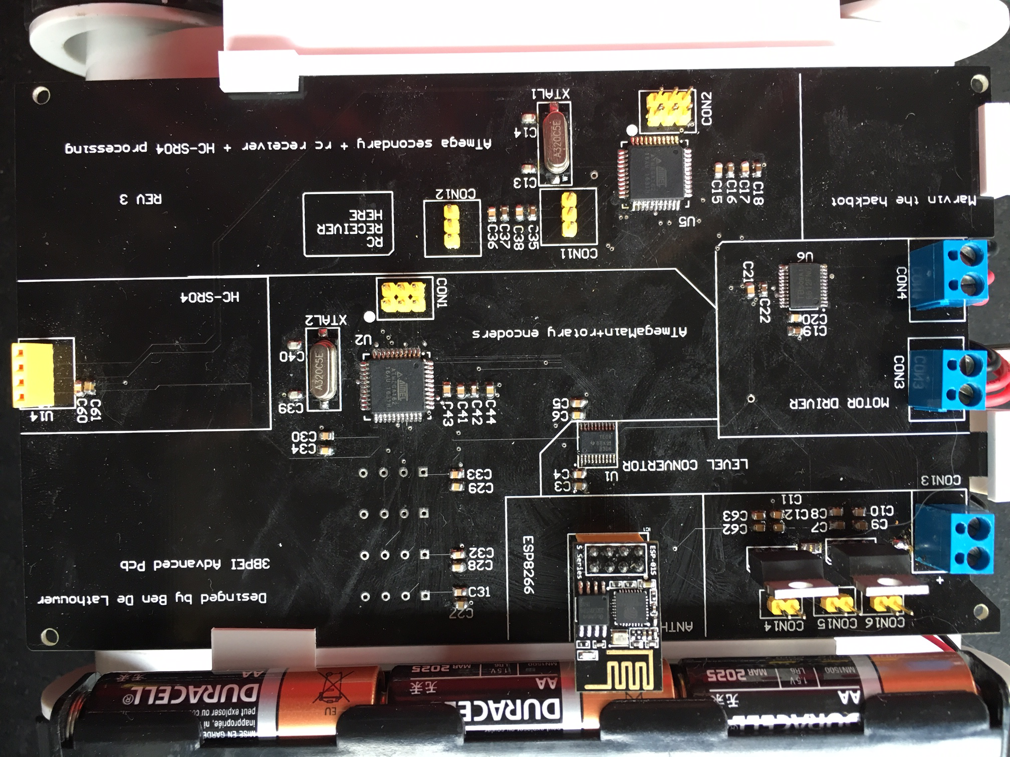
av en presentatie/IMG_7329.JPG
