bendelathouwer/Advanced-PCB/av en presentatie/programmer omgeving.PNG

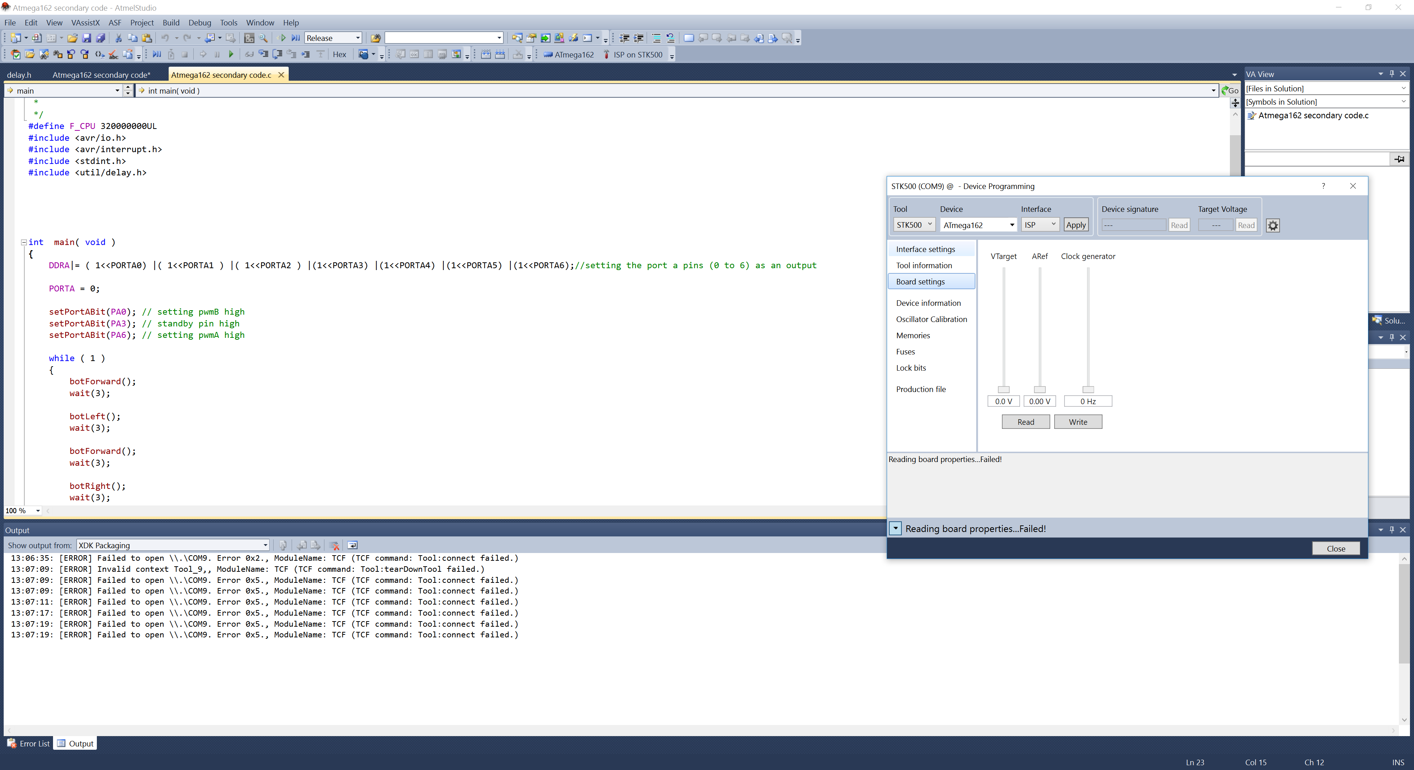
av en presentatie/programmer omgeving.PNG
