bendelathouwer/Advanced-PCB/av en presentatie/psuv2.PNG

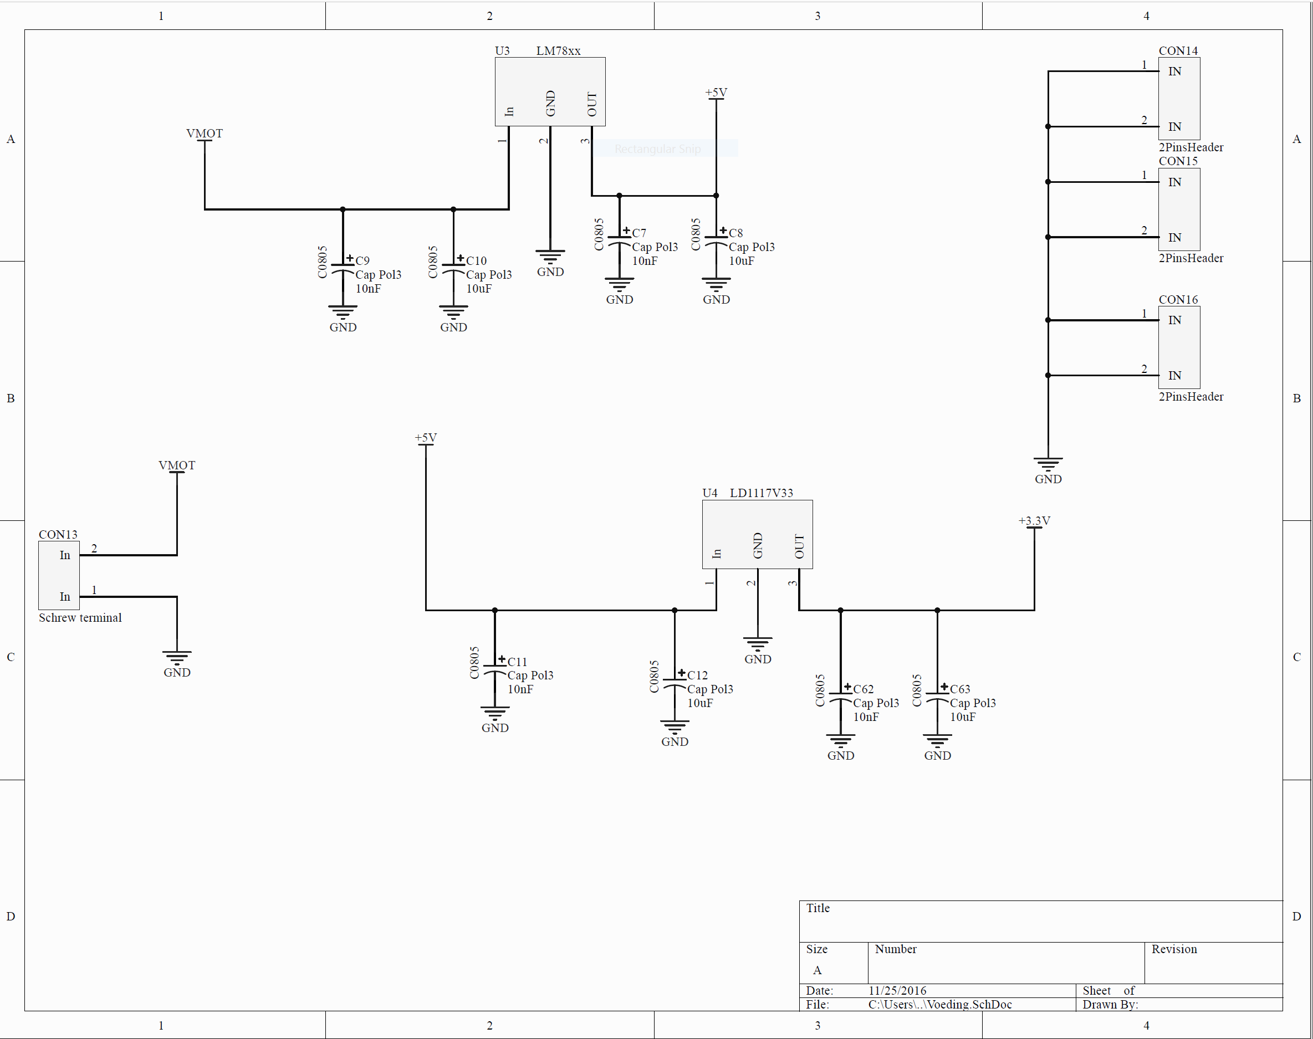
av en presentatie/psuv2.PNG
