bendelathouwer/Advanced-PCB/bestelbon farnell.xlsx

bestelbon project advanced pcb
aantal |  | weblink |  | totaale kostprijs
15 | http://be.farnell.com/bourns/nsmf020-2/multifuse-smd-0-2a/dp/1206716 |  |  |  | 11,70euro
50 | http://be.farnell.com/avx/08051a120jat2a/cap-mlcc-c0g-np0-12pf-100v-0805/dp/1740650 |  |  |  | 4.40euro
3 | http://be.farnell.com/atmel/atmega162-16au/mcu-8bit-atmega-16mhz-tqfp-44/dp/9171150 |  |  |  | 19euro
20 | http://be.farnell.com/multicomp/mc12cf-002/fuse-smd-1206-2a/dp/1841029 |  |  |  | 9euro
40 | http://be.farnell.com/murata/grm21br61c106ke15l/cap-mlcc-x5r-10uf-16v-0805/dp/1762635 |  |  |  | 7euro
 |  |  | totaal |  | 51.10 euro
