bendelathouwer/Advanced-PCB/kostensheet.xlsx

prijslijst | prijs
componenten | 114euro
pcb | 65 euro
asamblage kosten
totaale prijs | 179 euro
