bendelathouwer/Advanced-PCB/DATSHEETS/Digi-key.xlsx

 | bestelijst Digi-key
onderdeel |  | stuks | totaale prijs | link
TBS6612FNG |  | 10 | 18 | http://www.digikey.de/product-detail/en/toshiba-semiconductor-and-storage/TB6612FNG,C,8,EL/TB6612FNGC8ELCT-ND/1730134?cur=EUR&lang=en
ATmega162 |  | 5 | 31,35 | http://www.digikey.de/product-detail/en/atmel/ATMEGA162-16AU/ATMEGA162-16AU-ND/739759
lm7805 |  | 10 | 13,60 | http://www.digikey.de/product-detail/en/texas-instruments/LM340T-5.0/296-39011-5-ND/5055991
LM1117T-3.3 |  | 10 | 11.33 | http://www.digikey.de/product-detail/en/texas-instruments/LM1117T-3.3-NOPB/LM1117T-3.3-NOPB-ND/363593
txb0108 |  | 10 | 15.22 | http://www.digikey.de/product-detail/en/texas-instruments/TXB0108PWR/296-21527-1-ND/1305700
10uF condensator |  | 25 | 2.72 | http://www.digikey.de/product-detail/en/murata-electronics-north-america/GRM21BR61D106ME15L/490-10513-1-ND/5026444
10nF |  | 25 | 0.5 | http://www.digikey.de/product-detail/en/yageo/CC0805KRX7R9BB103/311-1136-1-ND/303046
totaal |  |  | 93
