bendelathouwer/Advanced-PCB/pcb/3d models/mf-nsmf020x.stp

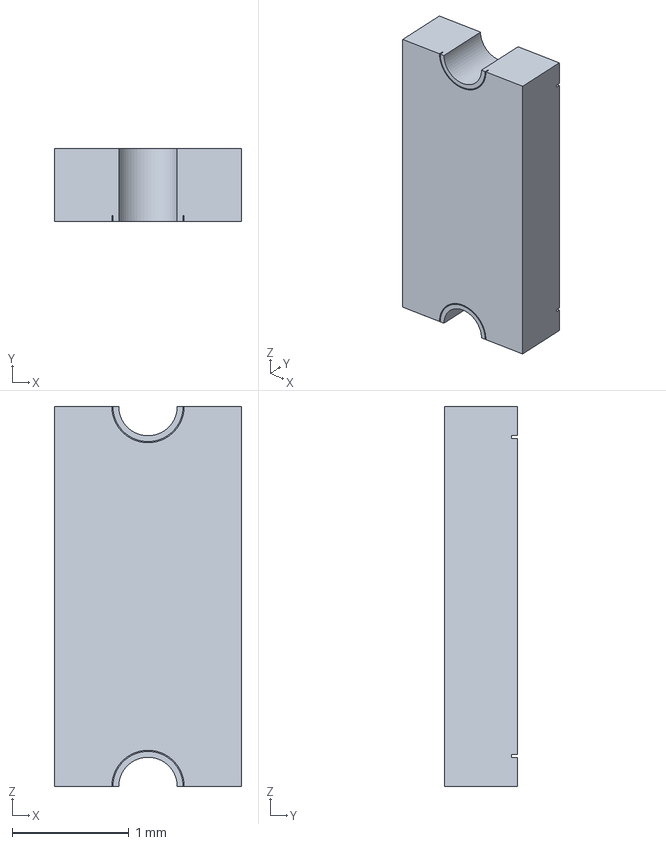
[picture p46: CAD file, 2016-12-14]
pcb/3d models/mf-nsmf020x.stp
1.60 x 0.625 x 3.25 mm
