bendelathouwer/Advanced-PCB/pcb/3d models/mf-nsmf020bourns.stp

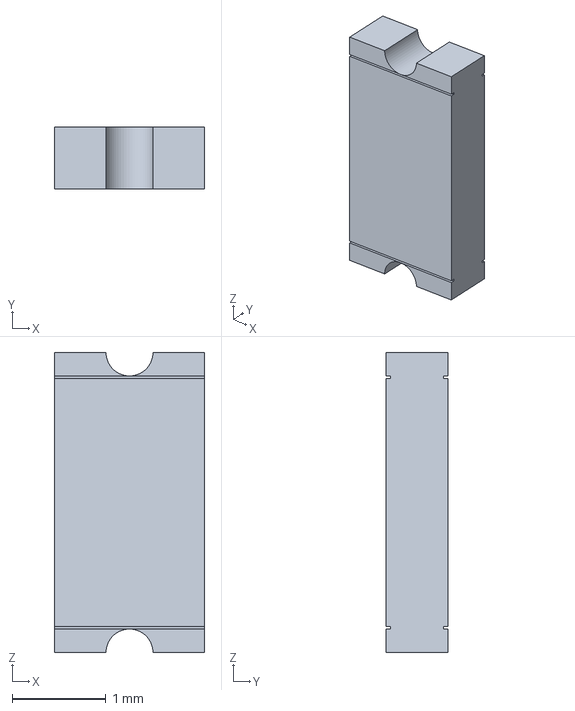
[picture p47: CAD file, 2016-12-14]
pcb/3d models/mf-nsmf020bourns.stp
1.60 x 0.665 x 3.20 mm
