bendelathouwer/Advanced-PCB/pcb/3d models/User Library-PinHeaderX5-1.STEP

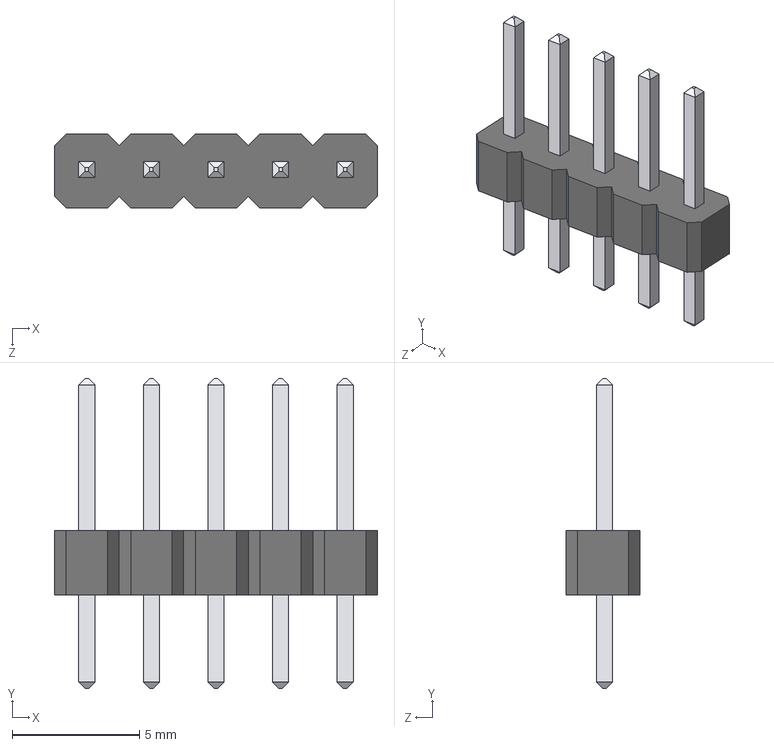
[picture p48: CAD file, 2016-12-14]
pcb/3d models/User Library-PinHeaderX5-1.STEP
12.7 x 12.2 x 2.92 mm
User Library-PinHeaderX5-1_PinHeaderX5_Pins_1
User Library-PinHeaderX5-1_PinHeaderX5_Body_1
