bendelathouwer/Advanced-PCB/pcb/3d models/BOB_09056.STL

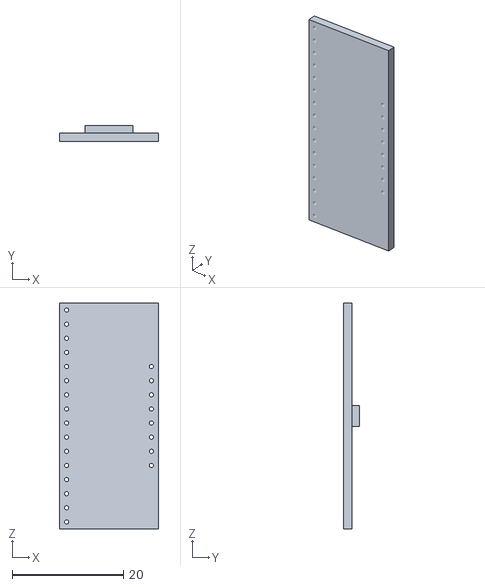
[picture p49: CAD file, 2016-10-28]
pcb/3d models/BOB_09056.STL
17.8 x 2.93 x 40.6
