bendelathouwer/Advanced-PCB/pcb/3d models/User Library-SOIC.step

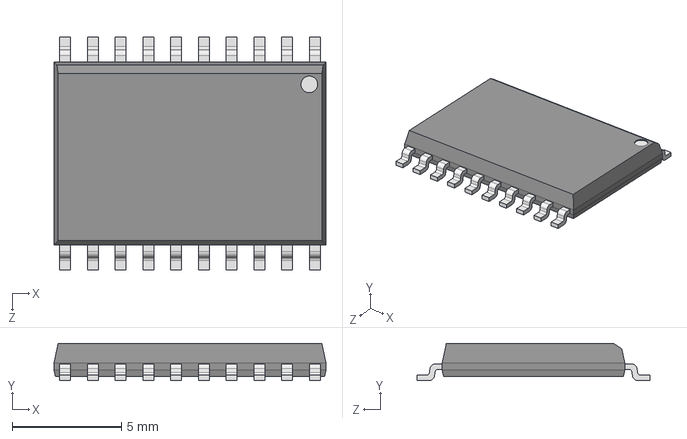
[picture p50: CAD file, 2016-10-28]
pcb/3d models/User Library-SOIC.step
12.4 x 1.70 x 10.6 mm
