bendelathouwer/Advanced-PCB/pcb/3d models/CircuitWorks-TO-220HS.step

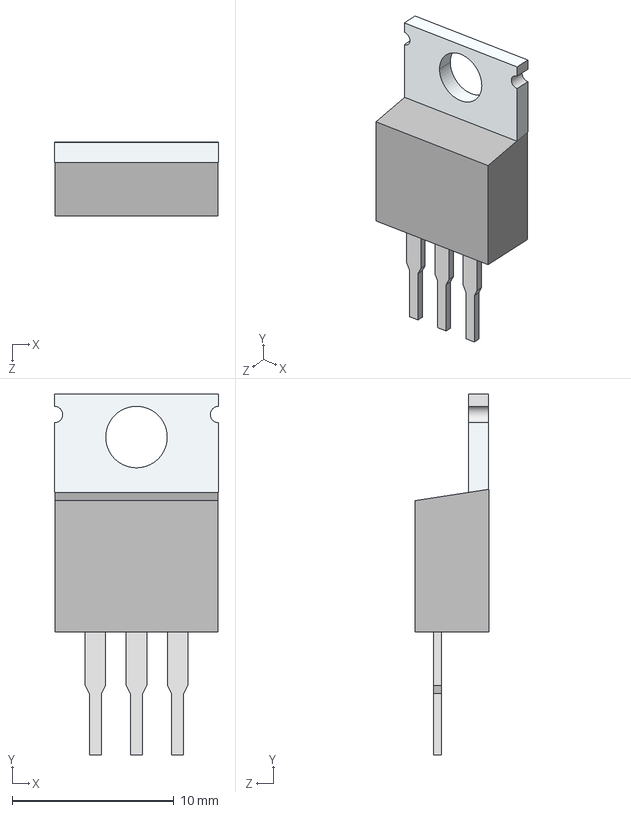
[picture p52: CAD file, 2016-10-05]
pcb/3d models/CircuitWorks-TO-220HS.step
10.2 x 22.4 x 4.57 mm
