bendelathouwer/Advanced-PCB/pcb/3d models/2pin.step

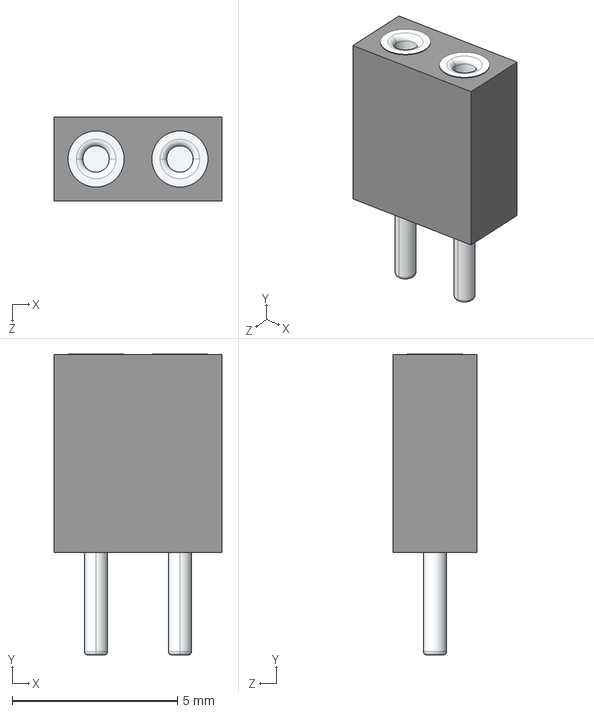
[picture p53: CAD file, 2016-10-03]
pcb/3d models/2pin.step
5.08 x 9.12 x 2.54 mm
