bendelathouwer/Advanced-PCB/pcb/3d models/SOT23.step

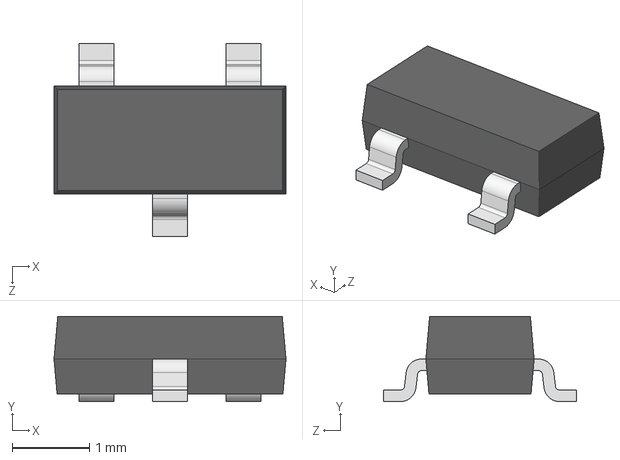
[picture p54: CAD file, 2016-10-03]
pcb/3d models/SOT23.step
3.00 x 1.10 x 2.50 mm
