bendelathouwer/Advanced-PCB/pcb/3d models/AtmelISp.step

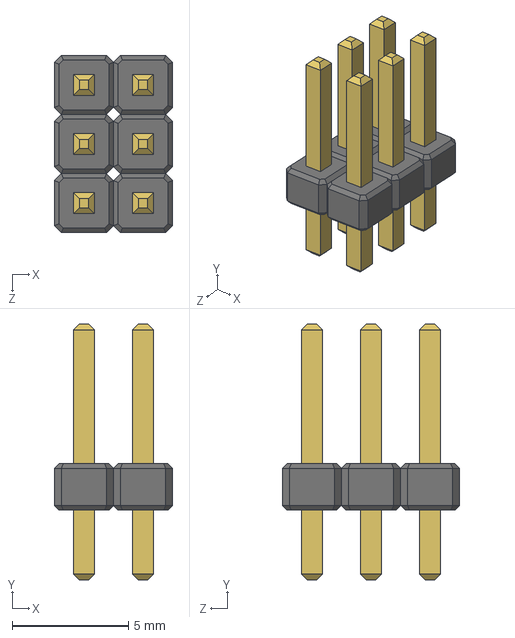
[picture p55: CAD file, 2016-10-03]
pcb/3d models/AtmelISp.step
5.08 x 11.0 x 7.62 mm
