bendelathouwer/Advanced-PCB/pcb/3d models/User Library-SOT-223-3.step

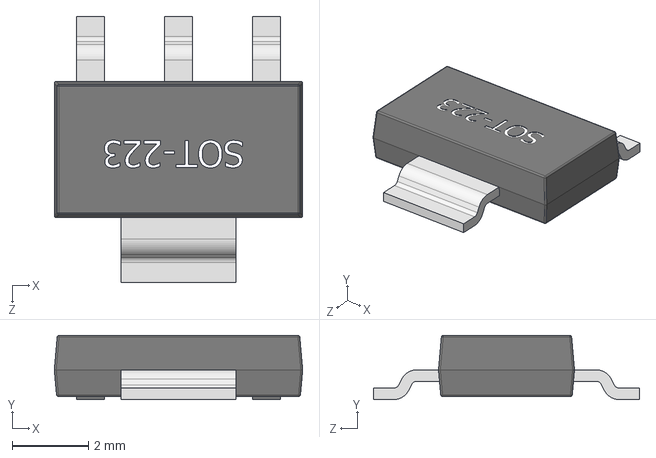
[picture p56: CAD file, 2016-10-03]
pcb/3d models/User Library-SOT-223-3.step
6.50 x 1.68 x 6.96 mm
