bendelathouwer/Advanced-PCB/pcb/3d models/TSSOP-20.step

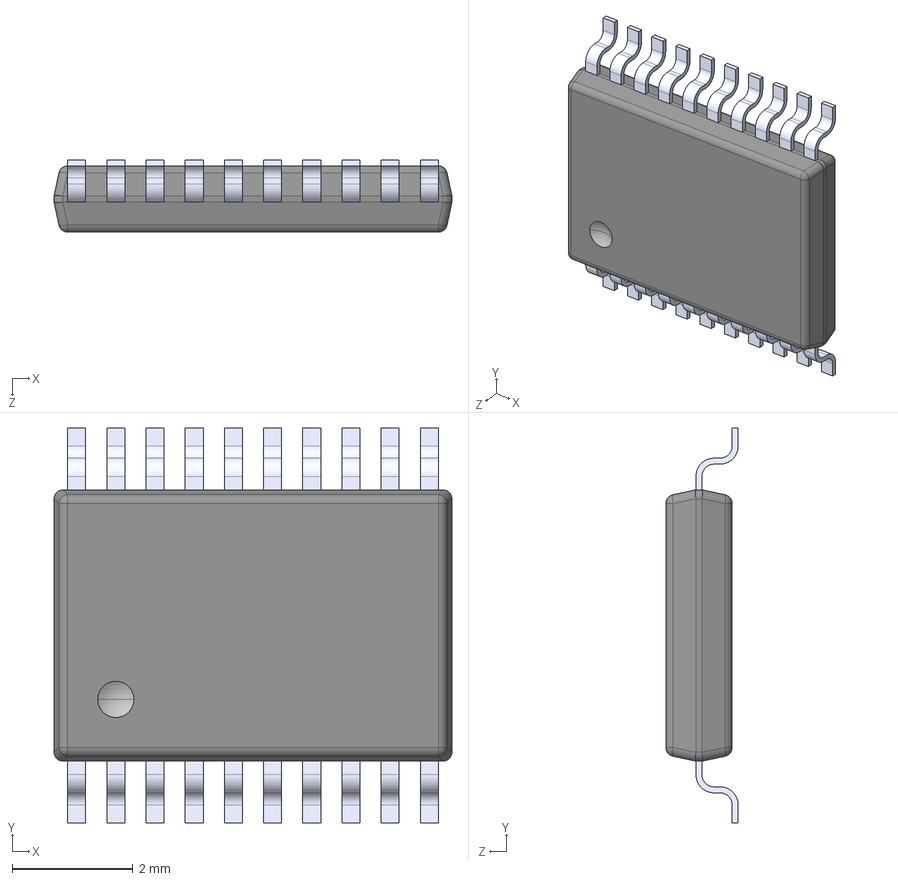
[picture p57: CAD file, 2016-10-03]
pcb/3d models/TSSOP-20.step
6.60 x 6.55 x 1.20 mm
