bendelathouwer/Advanced-PCB/pcb/3d models/TQFP-44.STEP

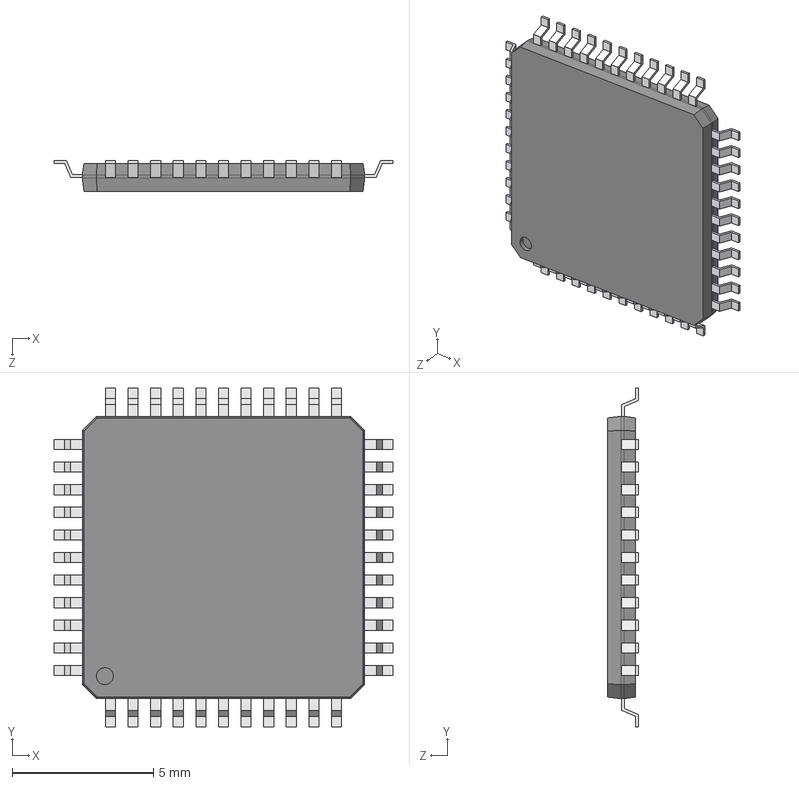
[picture p58: CAD file, 2016-10-03]
pcb/3d models/TQFP-44.STEP
12.0 x 12.0 x 1.10 mm
User Library-TQFP-44-1_pin001
User Library-TQFP-44-1_pin021
User Library-TQFP-44-1_pin022
User Library-TQFP-44-1_pin020
User Library-TQFP-44-1_pin019
User Library-TQFP-44-1_pin018
User Library-TQFP-44-1_pin017
User Library-TQFP-44-1_pin024
User Library-TQFP-44-1_pin023
User Library-TQFP-44-1_pin007
User Library-TQFP-44-1_pin003
User Library-TQFP-44-1_pin015
User Library-TQFP-44-1_pin014
User Library-TQFP-44-1_pin013
User Library-TQFP-44-1_pin012
User Library-TQFP-44-1_pin011
User Library-TQFP-44-1_pin010
User Library-TQFP-44-1_pin009
User Library-TQFP-44-1_pin008
User Library-TQFP-44-1_pin006
User Library-TQFP-44-1_pin005
User Library-TQFP-44-1_pin004
User Library-TQFP-44-1_pin002
User Library-TQFP-44-1_pin016
User Library-TQFP-44-1_pin027
User Library-TQFP-44-1_pin037
User Library-TQFP-44-1_pin025
User Library-TQFP-44-1_pin026
User Library-TQFP-44-1_pin036
User Library-TQFP-44-1_pin035
User Library-TQFP-44-1_pin034
User Library-TQFP-44-1_pin033
User Library-TQFP-44-1_pin032
User Library-TQFP-44-1_pin031
User Library-TQFP-44-1_pin030
User Library-TQFP-44-1_pin029
User Library-TQFP-44-1_pin028
User Library-TQFP-44-1_pin038
User Library-TQFP-44-1_pin044
User Library-TQFP-44-1_pin043
User Library-TQFP-44-1_pin042
User Library-TQFP-44-1_pin041
User Library-TQFP-44-1_pin040
User Library-TQFP-44-1_pin039
User Library-TQFP-44-1_Body
