bendelathouwer/Advanced-PCB/pcb/3d models/User Library-1x3 TH Pitch 2_54mm.SLDPRT

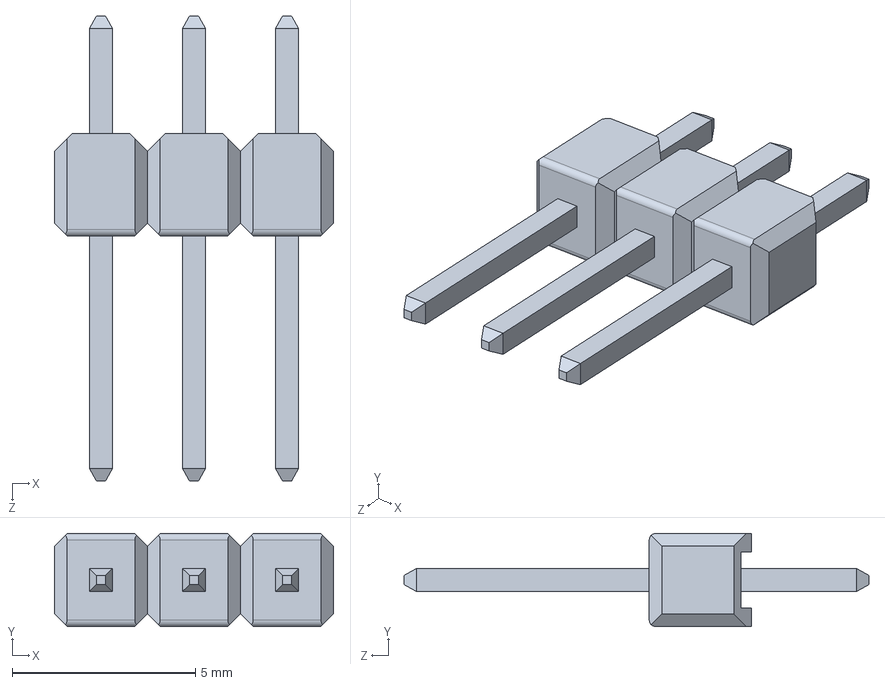
[picture p59: CAD file, 2016-10-03]
pcb/3d models/User Library-1x3 TH Pitch 2_54mm.SLDPRT
7.62 x 2.54 x 12.7 mm
