bendelathouwer/Advanced-PCB/pcb/3d models/User Library-User Library-TSSOP-24.step

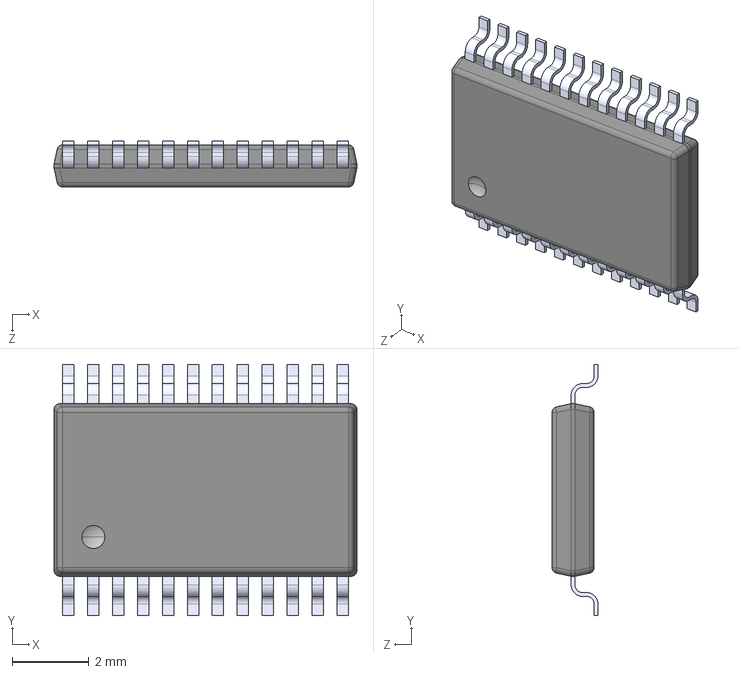
[picture p60: CAD file, 2016-10-03]
pcb/3d models/User Library-User Library-TSSOP-24.step
7.90 x 6.55 x 1.20 mm
