bendelathouwer/Advanced-PCB/pcb/3d models/SOIC8.SLDPRT

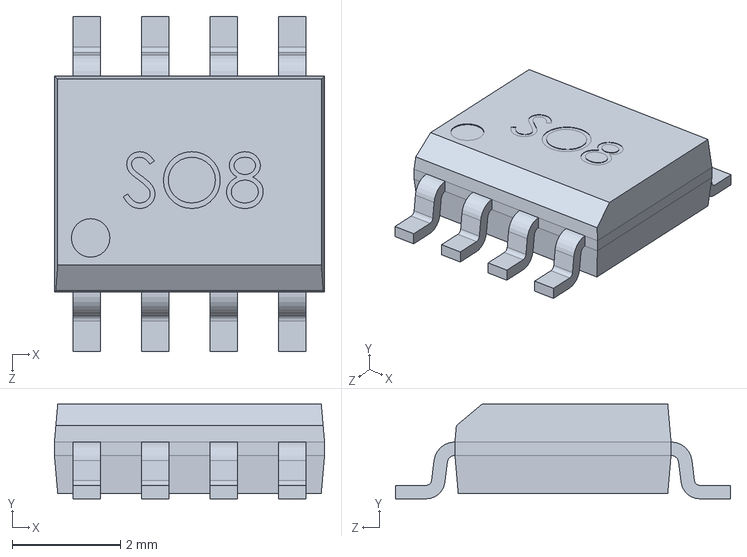
[picture p61: CAD file, 2016-10-03]
pcb/3d models/SOIC8.SLDPRT
5.00 x 1.75 x 6.20 mm
