bendelathouwer/Advanced-PCB/pcb/3d models/4187.stp

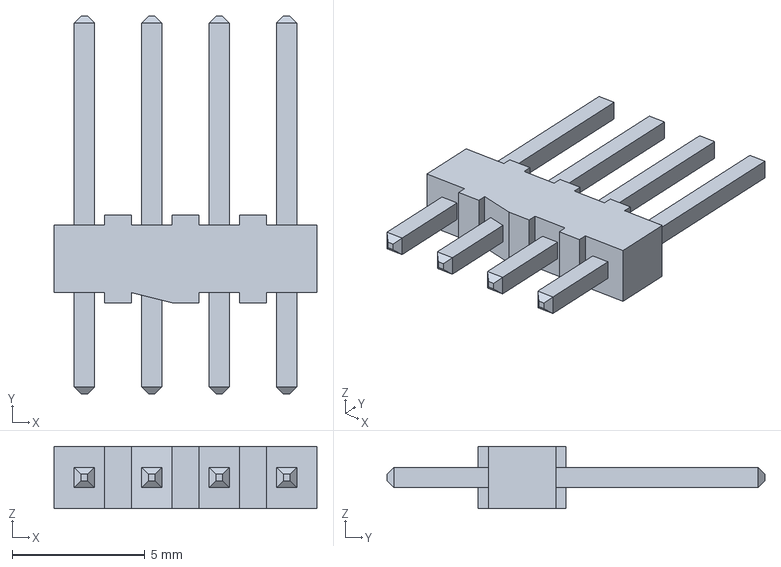
[picture p62: CAD file, 2016-10-03]
pcb/3d models/4187.stp
9.91 x 14.2 x 2.34 mm
