bendelathouwer/Advanced-PCB/pcb/3d models/esp8266.step

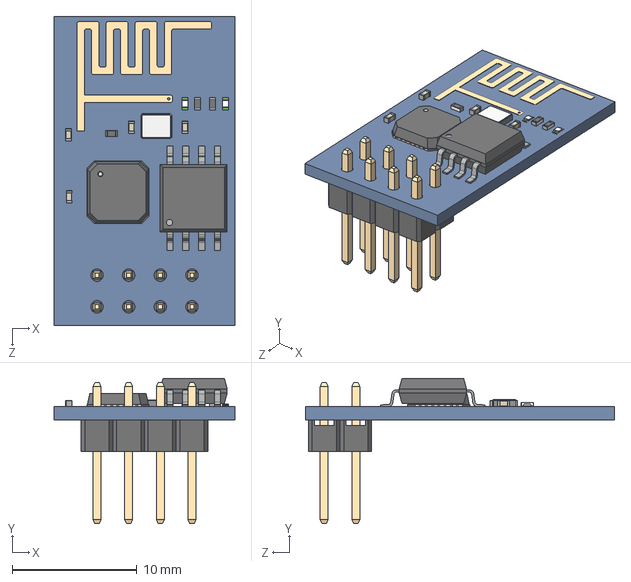
[picture p63: CAD file, 2016-10-03]
pcb/3d models/esp8266.step
14.5 x 11.7 x 24.8 mm
