bendelathouwer/Advanced-PCB/pcb/3d models/XFL4020.STEP

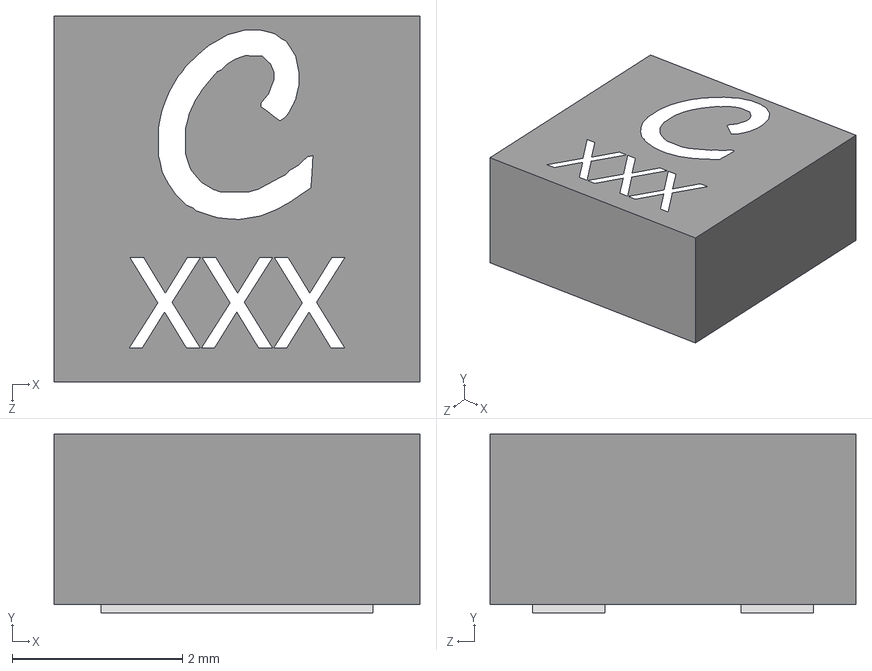
[picture p64: CAD file, 2016-10-03]
pcb/3d models/XFL4020.STEP
4.30 x 2.10 x 4.30 mm
User Library-XFL4020_1_1
User Library-XFL4020_2_1
User Library-XFL4020_3_1
User Library-XFL4020_4_1
User Library-XFL4020_5_1
User Library-XFL4020_6_1
User Library-XFL4020_7_1
