bendelathouwer/Advanced-PCB/pcb/3d models/SSOP 24 PIN_.step

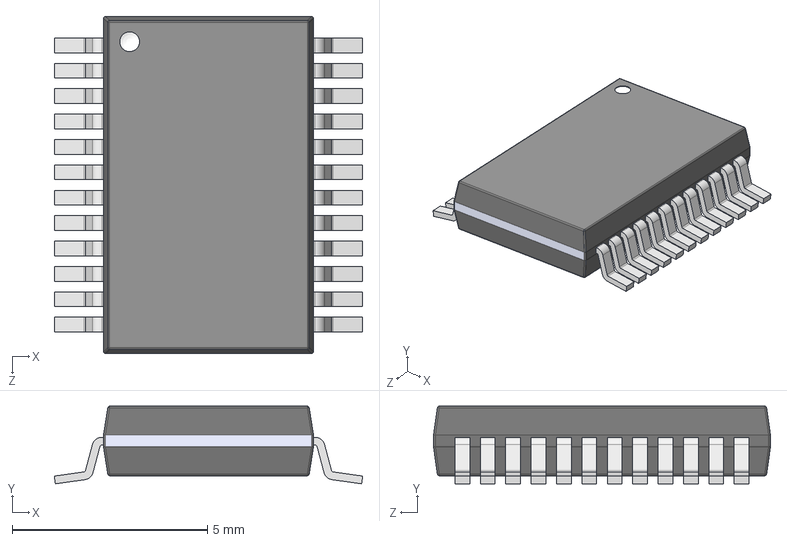
[picture p65: CAD file, 2016-10-03]
pcb/3d models/SSOP 24 PIN_.step
7.90 x 1.99 x 8.63 mm
