bendelathouwer/Advanced-PCB/pcb/3d models/10WSON.step

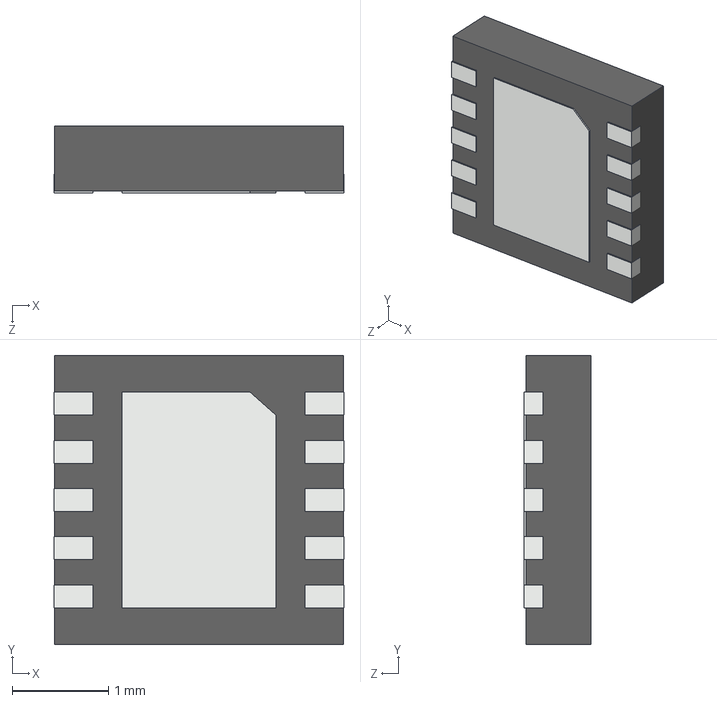
[picture p66: CAD file, 2016-10-03]
pcb/3d models/10WSON.step
3.01 x 3.00 x 0.695 mm
