bendelathouwer/Advanced-PCB/pcb/3d models/User Library-header90-4.STEP

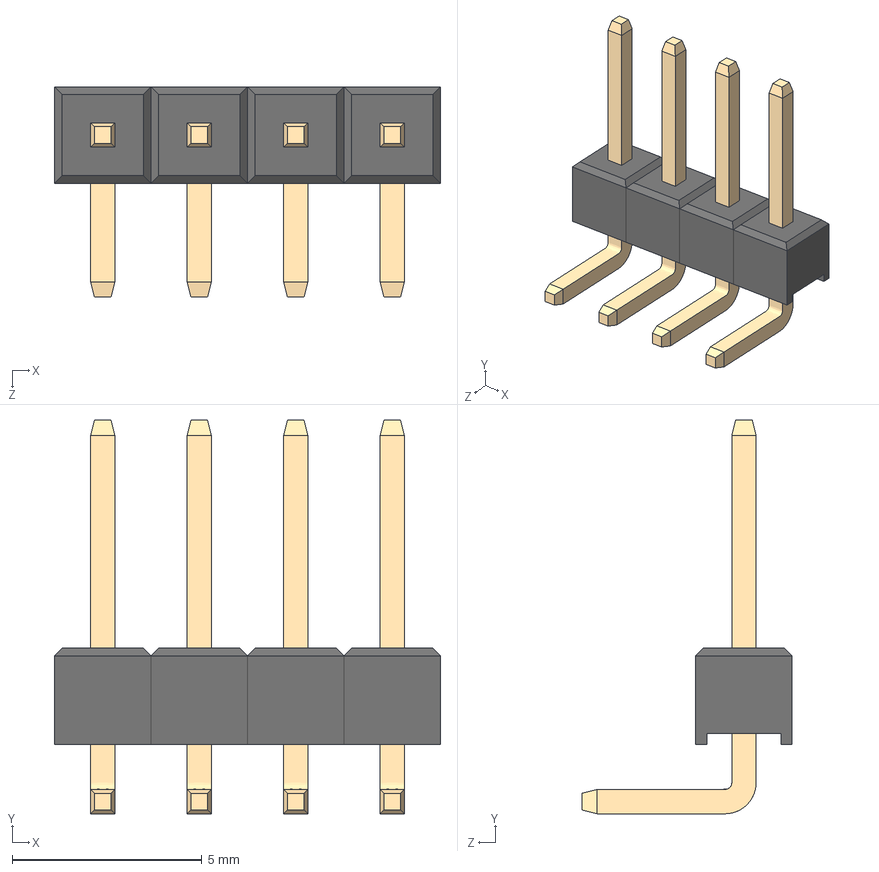
[picture p67: CAD file, 2016-10-03]
pcb/3d models/User Library-header90-4.STEP
10.2 x 10.4 x 5.54 mm
User Library-header90-4_Header90-1 x 4
