bendelathouwer/Advanced-PCB/pcb/3d models/Connector 3-pin.step

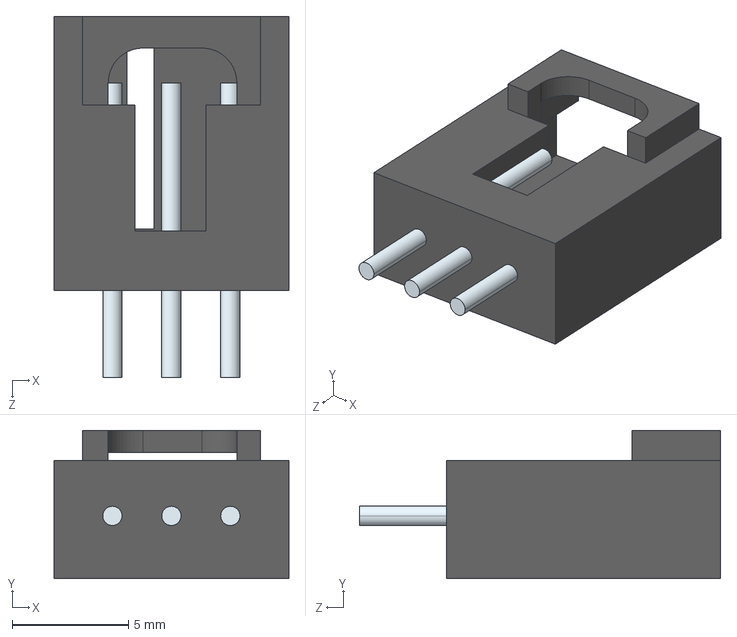
[picture p68: CAD file, 2016-10-03]
pcb/3d models/Connector 3-pin.step
10.1 x 6.39 x 15.6 mm
