bendelathouwer/Advanced-PCB/pcb/3d models/User Library-HC49US.STEP

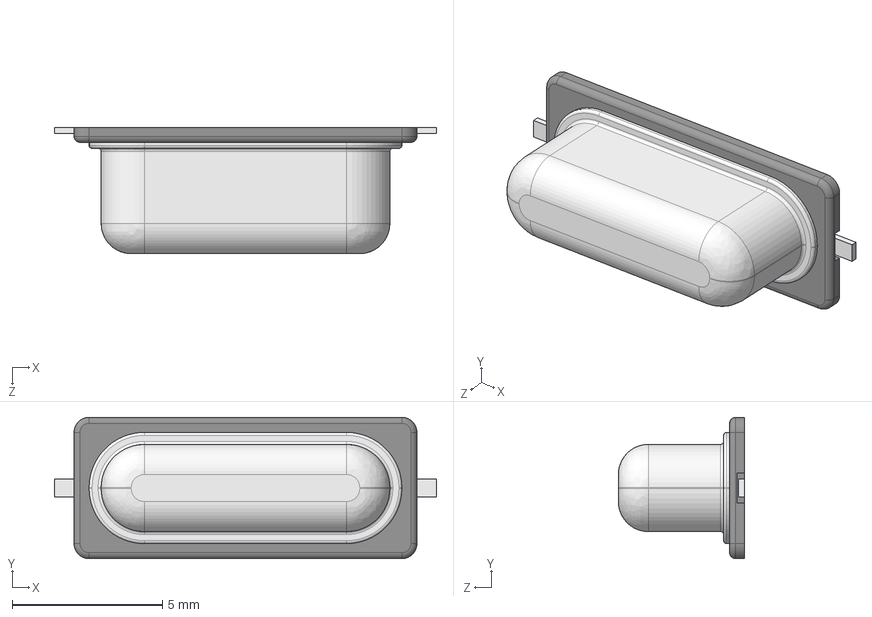
[picture p69: CAD file, 2016-10-03]
pcb/3d models/User Library-HC49US.STEP
12.7 x 4.70 x 4.20 mm
User Library-HC49US_Fusion002
User Library-HC49US_Fillet005
User Library-HC49US_Fillet006
