bendelathouwer/Advanced-PCB/pcb/3d models/User Library-so8-3.step

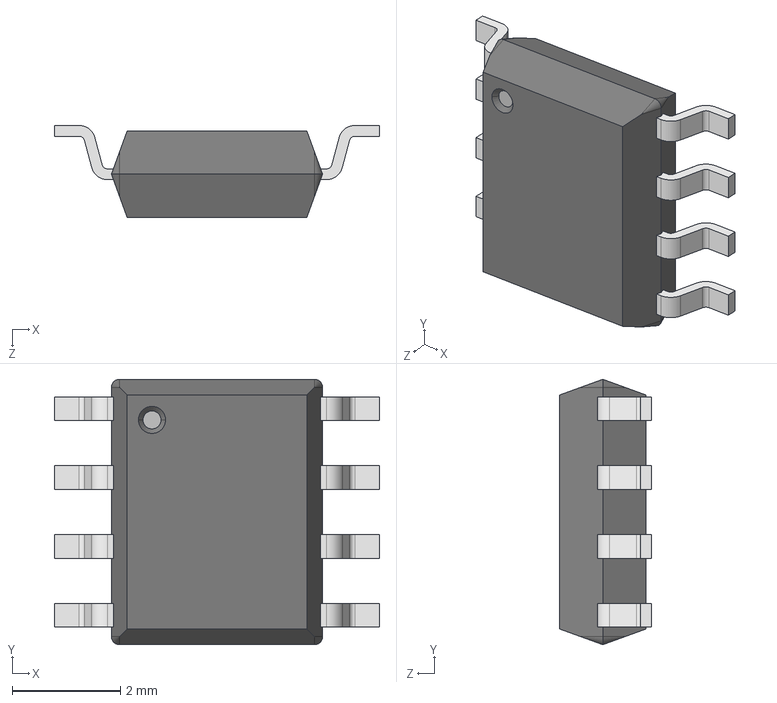
[picture p70: CAD file, 2016-10-03]
pcb/3d models/User Library-so8-3.step
6.00 x 4.90 x 1.70 mm
