bendelathouwer/Advanced-PCB/pcb/3d models/User Library-P-LQFP48-7x7-0_50.step

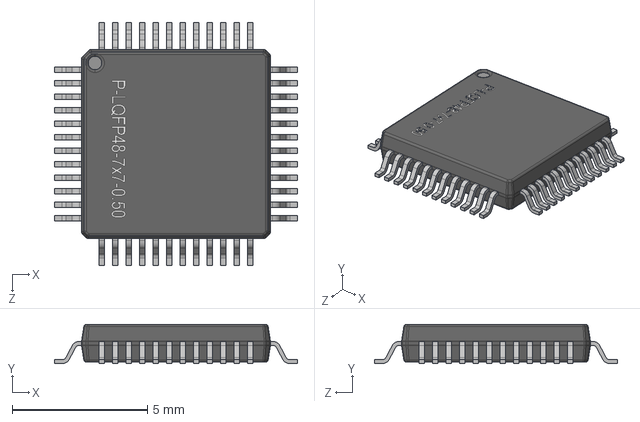
[picture p71: CAD file, 2016-10-03]
pcb/3d models/User Library-P-LQFP48-7x7-0_50.step
9.00 x 1.45 x 9.00 mm
