bendelathouwer/Advanced-PCB/(list of files, cad)

Other CAD files:
pcb/3d models/17573.stp
pcb/3d models/User Library-2 Way PCB Screw Terminal Block 5mm.step
pcb/3d models/Way PCB Screw Terminal Block .x_t
