bendelathouwer/Advanced-PCB/(list of files, drawings)

Other design files:
pcb/2PinsHeader.PcbLib
pcb/2pinsHeader.SchLib
pcb/ACS711.PcbLib
pcb/ACS711.SchLib
pcb/ADC.SchDoc
pcb/ATMEGA126.SchLib
pcb/ATmega162.PcbLib
pcb/Atmega secondary.SchDoc
pcb/ATmegaMain.SchDoc
pcb/battery current sensor.SchDoc
pcb/Beveiliging.PcbLib
pcb/Beveiliging.SchLib
pcb/coil.PcbLib
pcb/COIL.SchLib
pcb/current sensors.SchDoc
pcb/encoder.SchDoc
pcb/ESP8266.SchDoc
pcb/INA219 sensor.SchDoc
pcb/LevelShifter.SchDoc
pcb/motor current sensor leftside.SchDoc
pcb/motordriver left side.SchDoc
pcb/motordriver.SchDoc
pcb/RC reciever.SchDoc
pcb/Robot.PrjPcb
pcb/ROBOTPCB.PcbDoc
pcb/STM32.SchDoc
pcb/Top.SchDoc
pcb/ultrasoon sensor.SchDoc
pcb/Voeding.SchDoc
