bendelathouwer/Advanced-PCB/(commit log)

2016-09-22 pcb
    pcb folder + altium project toegevoegd
    [MPPT+invertor .PrjPcb]
2016-09-22 conector lib
    conector lib toegevoeg
    [Conectors.PcbLib, Input.SchDoc, MPPT+invertor .PrjPcb, conectors.SchLib]
2016-09-22 fuse
    added footprint for fuse
    [Beveiliging.PcbLib, Beveiliging.SchLib, MPPT+invertor .PrjPcb]
2016-09-24 3d boddy en bestelijst farnell
    [Beveiliging.PcbLib, Beveiliging.SchLib, Input.SchDoc, MIDI.stp, MPPT+invertor .PrjPcb, conectors.SchLib, kabels en conectoren.SchLib, prijs schatting.xlsx]
2016-09-27 pcb
    verder getekend aan pcb
    [Beveiliging.PcbLib, Input.SchDoc, MPPT+invertor .PrjPcb, halfgelijders.SchLib, halgeleiders.PcbLib, kabels en conectoren.SchLib, prijs schatting.xlsx]
2016-10-03 pcb tekenen
    footprints getekend
    [10WSON.step, 17573.stp, 2PinsHeader.PcbLib, 2pin.step, 2pinsHeader.SchLib, 4187.stp, ACS711.PcbLib, ACS711.SchLib]
2016-10-03 libary's aangepast
    verschijnende libary's aangepast
    [ACS711.PcbLib, ACS711.SchLib, ATmega162.PcbLib, ESP8266.SchLib, RcCon.SchLib, Robot.PrjPcb, TXB0108.PcbLib, Top.SchDoc]
2016-10-05 pcb
    footprint motordriver getekent
    [2pinsHeader.SchLib, ACS711.PcbLib, ATMEGA126.SchLib, ATmega162.PcbLib, COIL.SchLib, CircuitWorks-TO-220HS.step, RcCon.SchLib, Robot.PrjPcb]
2016-10-13 datasheet en 3d models
    datasheets toegevoegd + 3d models geplaatst
    [ACS711.PcbLib, ATMEGA126.SchLib, ATmega162.PcbLib, ESP8266.SchDoc, Robot.PrjPcb, STM32.SchDoc, SW3dPS-PowSO30-ST.STEP, TPS690xx.PcbLib]
2016-10-13 schema
    schema getekend
    [ATMEGA126.SchLib, ATmega.SchDoc, ESP8266.SchDoc, ESP8266.SchLib, LevelShifter.SchDoc, Robot.PrjPcb, STM32.SchDoc, TPS690xx.PcbLib]
2016-10-14 footprint
    footprint+ schema verder gemaakt
    [ACS711.PcbLib, ATmega.SchDoc]
2016-10-28 foorptints + schemas
    adc schema + footprint toegevoegd
    [ADC.SchDoc, ATmega.SchDoc, ATmega162.PcbLib, ATmegaMain.SchDoc, Atmega secondary.SchDoc, BOB_09056.STL, ESP8266.SchDoc, LevelShifter.SchDoc]
2016-11-09 pcb
    begining to drow pcb
    [ACS711.PcbLib, ADC.SchDoc, ATMEGA126.SchLib, ATmega162.PcbLib, ATmegaMain.SchDoc, Atmega secondary.SchDoc, LevelShifter.SchDoc, RC reciever.SchDoc]
2016-11-09 schema
    added ultrasoon schematic
    [Atmega secondary.SchDoc, ROBOTPCB.PcbDoc, Robot.PrjPcb, Top.SchDoc, ultrasoon sensor.SchDoc, ultrasoonSensor.PcbLib]
2016-11-09 PCB
    started drawing pcb
    [ROBOTPCB.PcbDoc, Robot.PrjPcb, Top.SchDoc]
2016-11-13 schematic improvements
    added some schematic improvements
    [ADC.SchDoc, ATmega162.PcbLib, ATmegaMain.SchDoc, LM78xx.SchLib, LevelShifter.SchDoc, ROBOTPCB.PcbDoc, Robot.PrjPcb, Top.SchDoc]
2016-11-14 PCB + cursus
    cursus toegevoegd + verder getekend aan pcb
    [RC reciever.SchDoc, ROBOTPCB.PcbDoc, Top.SchDoc, Voeding.SchDoc, prijs schatting.xlsx]
2016-11-16 rev4
    4de iteratie
    [ADC.SchDoc, ATmegaMain.SchDoc, Atmega secondary.SchDoc, ROBOTPCB.PcbDoc, Robot.PrjPcb, Top.SchDoc, Voeding.SchDoc, current sensors.SchDoc]
2016-11-17 routing V2
    verder geroute aan men pcb
    [ROBOTPCB.PcbDoc]
2016-11-19 pcb afgetekend
    pcb is af getekend
    [ATmegaMain.SchDoc, ROBOTPCB.PcbDoc, Robot.PrjPcb, Top.SchDoc, current sensors.SchDoc, motordriver.SchDoc]
2016-11-19 files gegenereerd + mounting holes
    mounting holes toegevoegd + gerber en nc drill files gegenereerd
    [ROBOTPCB.PcbDoc]
2016-11-19 a
    a
    [ROBOTPCB.PcbDoc]
2016-11-21 final rev + prijslijst
    finale revisie pcb + opmaken stuklijst
    [ATmega162.PcbLib, Digi-key.xlsx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]
2016-12-14 ppt and revision 3 of pcb
    started on rev 3 pcb and ppt for final evaluation
    [ACS711.PcbLib, ATMEGA126.SchLib, ATmega162.PcbLib, ATmegaMain.SchDoc, Atmega secondary.SchDoc, ESP8266.SchDoc, INA219 sensor.SchDoc, LevelShifter.SchDoc]
2016-12-17 verbeterd ppt
    ppt verbeterd volgens de bespreking met de proffen
    [ATMEGA126.SchLib, ATmega162.PcbLib, Atmega secondary.SchDoc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]
2016-12-29 V4
    removed another bug (pwm source ) from the desinge
    only needs to be rerouted
    [ATMEGA126.SchLib, ATmegaMain.SchDoc, Atmega secondary.SchDoc, INA219 sensor.SchDoc, LevelShifter.SchDoc, ROBOTPCB.PcbDoc, Robot.PrjPcb, TLC1543CDWG4.SchLib]
2017-01-21 rev 4
    verbeterde versie print plaat (ultrasoon sensor moet nog herzien worden)
    [ATmegaMain.SchDoc, Atmega secondary.SchDoc, ESP8266.SchDoc, LevelShifter.SchDoc, RC reciever.SchDoc, ROBOTPCB.PcbDoc, Robot.PrjPcb, Voeding.SchDoc]
2017-01-28 poster + ppt + demo code
    added demo code +powerpoint presentation and poster
2017-02-21 update
    made a central reposetory for my altium footprints
    [Conectors.PcbLib, ESP8266.SchLib, IISP_Header.PcbLib, IISP_Header.SchLib, LM78xx.SchLib, MC34063 .SchLib, MC34063.PcbLib, ROBOTPCB.PcbDoc]
